servodevelop/piper-mate/hardware/README.md

# PiPER-Mate hardware

[← PiPER-Mate](../README.md)　|　<sub>**English** / [简体中文](README.zh.md)</sub>

<p align="center">
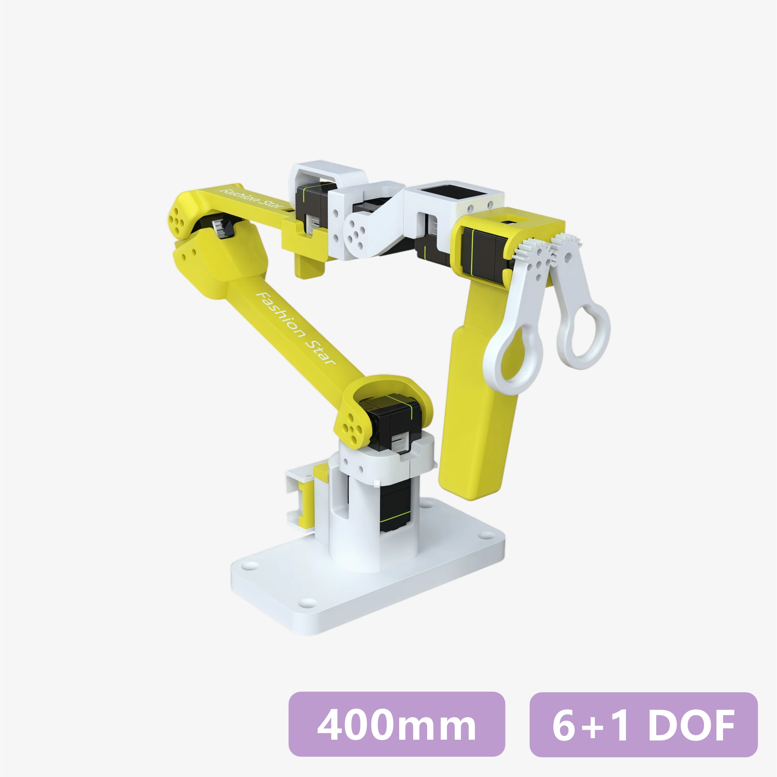
[picture p1: hardware/images/piper-mate-main-image-01.webp]
PiPER-Mate product view 1
  
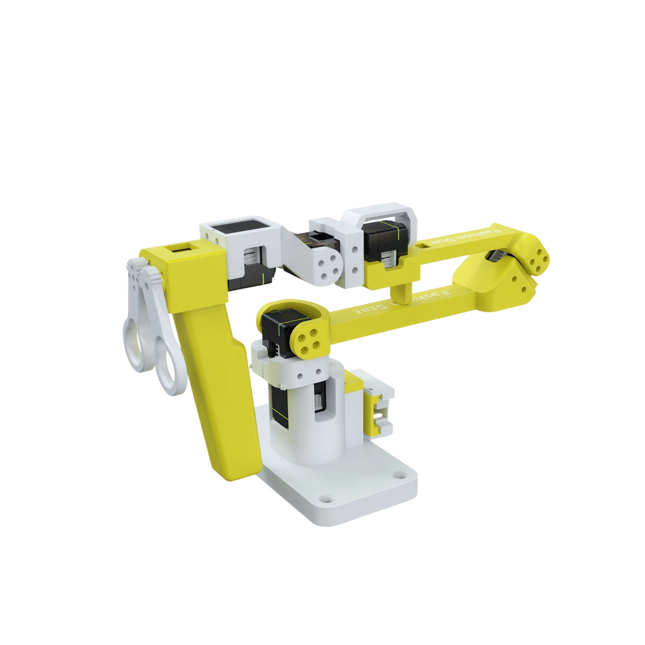
[picture p2: hardware/images/piper-mate-main-image-02.webp]
PiPER-Mate product view 2
  
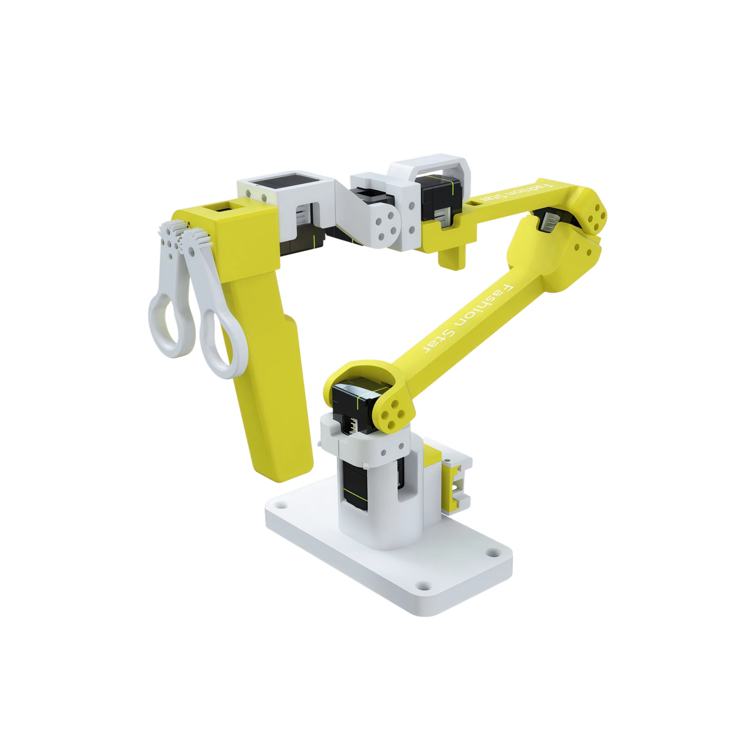
[picture p3: hardware/images/piper-mate-main-image-03.webp]
PiPER-Mate product view 3
  
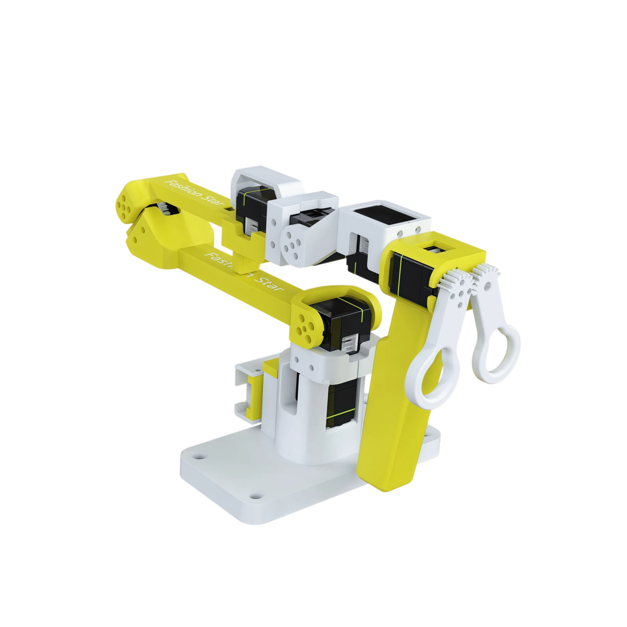
[picture p4: hardware/images/piper-mate-main-image-04.webp]
PiPER-Mate product view 4
  
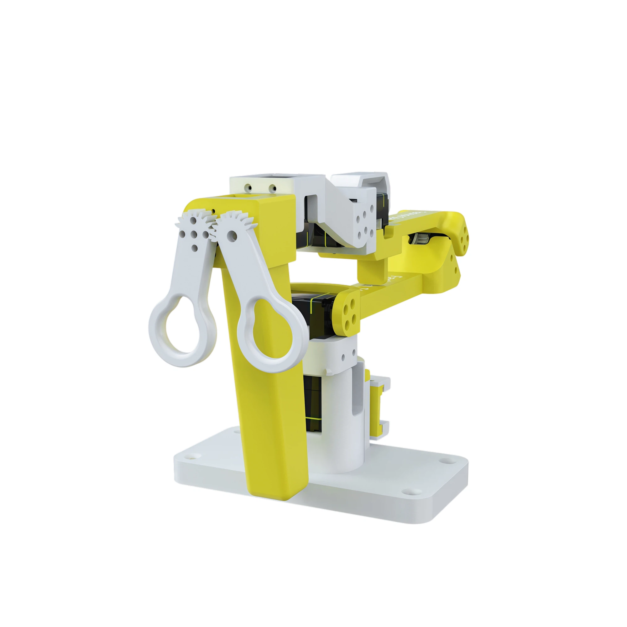
[picture p5: hardware/images/piper-mate-main-image-05.webp]
PiPER-Mate product view 5
  
</p>

**Contents:**

- [📂 Resources](#resources)
- [📋 Bill of Materials](#bill-of-materials)
- [🔢 Joint and servo ID mapping](../docs/specifications.md#joint-ids-and-names)

## Resources

| Directory | Description | Status |
| --- | --- | --- |
| [step/](step/) | [Complete assembly STEP](step/piper-mate.step) | ✅ Complete |
| [3mf/](3mf/) | 3D printing files (3MF) | — Coming soon |
| [drawings/](drawings/) | Dimension drawing in PDF and DWG | ✅ Complete |

The STEP assembly is a neutral CAD reference based on the supplied 2026-10-27 release folder.

The assembly tree groups the printed parts under `3D Printed Parts (11)` and the seven servos under `Servos (7)`. Servo instances are labeled `J1-ID0-RP6-U15H-M` through `J7-ID6-RP6-U15H-M (Handle)`; printed-part labels are `piper-mate-base`, `piper-mate-link 1`–`5`, `piper-mate-handle`, and `piper-mate-finger-ring-right` / `left`. The UC-01 adapter board cover and base are also in this group.

## Bill of Materials

The table lists **21 installed items**, with servos listed first. The Model / Specification column uses standardized identifiers for printed parts.

3MF printing files will be provided in [3mf/](3mf/); they are not yet available. Print settings are not listed here; choose layer height, wall count and infill for your printer and filament.

Screw images in rows 17–19 are AI-generated illustrations. The proportions in rows 17–18 have been adjusted for M1.6 × 4 mm; they are not dimensioned manufacturing drawings. Use the specification column for purchasing.

Cable images in rows 13–16 are AI-generated illustrations based on the connector reference. They are not to scale and do not define pin assignments; use the specification column for cable lengths and verify wiring against the actual hardware.

| No. | Part Name | Model / Specification | Image | Description | Quantity |
| :---: | --- | --- | :---: | --- | :---: |
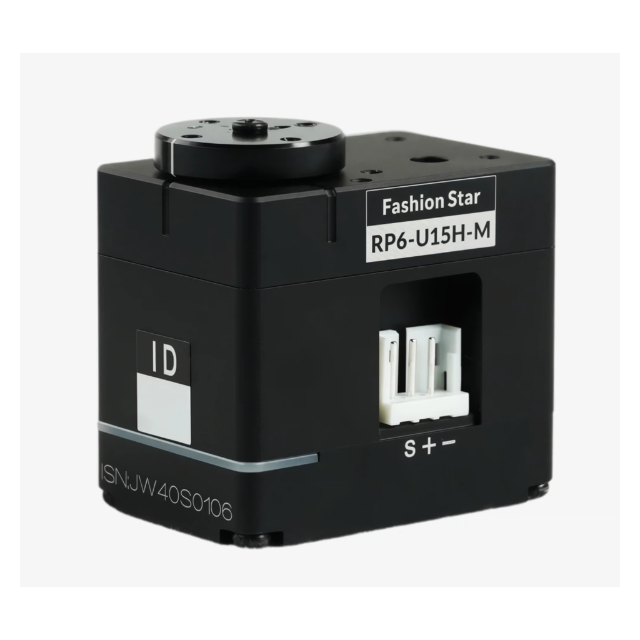
[picture p6: hardware/images/rp6-u15h-m.png]
RP6-U15H-M
| 1 | UART bus servo | RP6-U15H-M |  | Coreless motor; 12-bit absolute encoder; six arm joints plus trigger; J1-ID0–J7-ID6 | 7 |
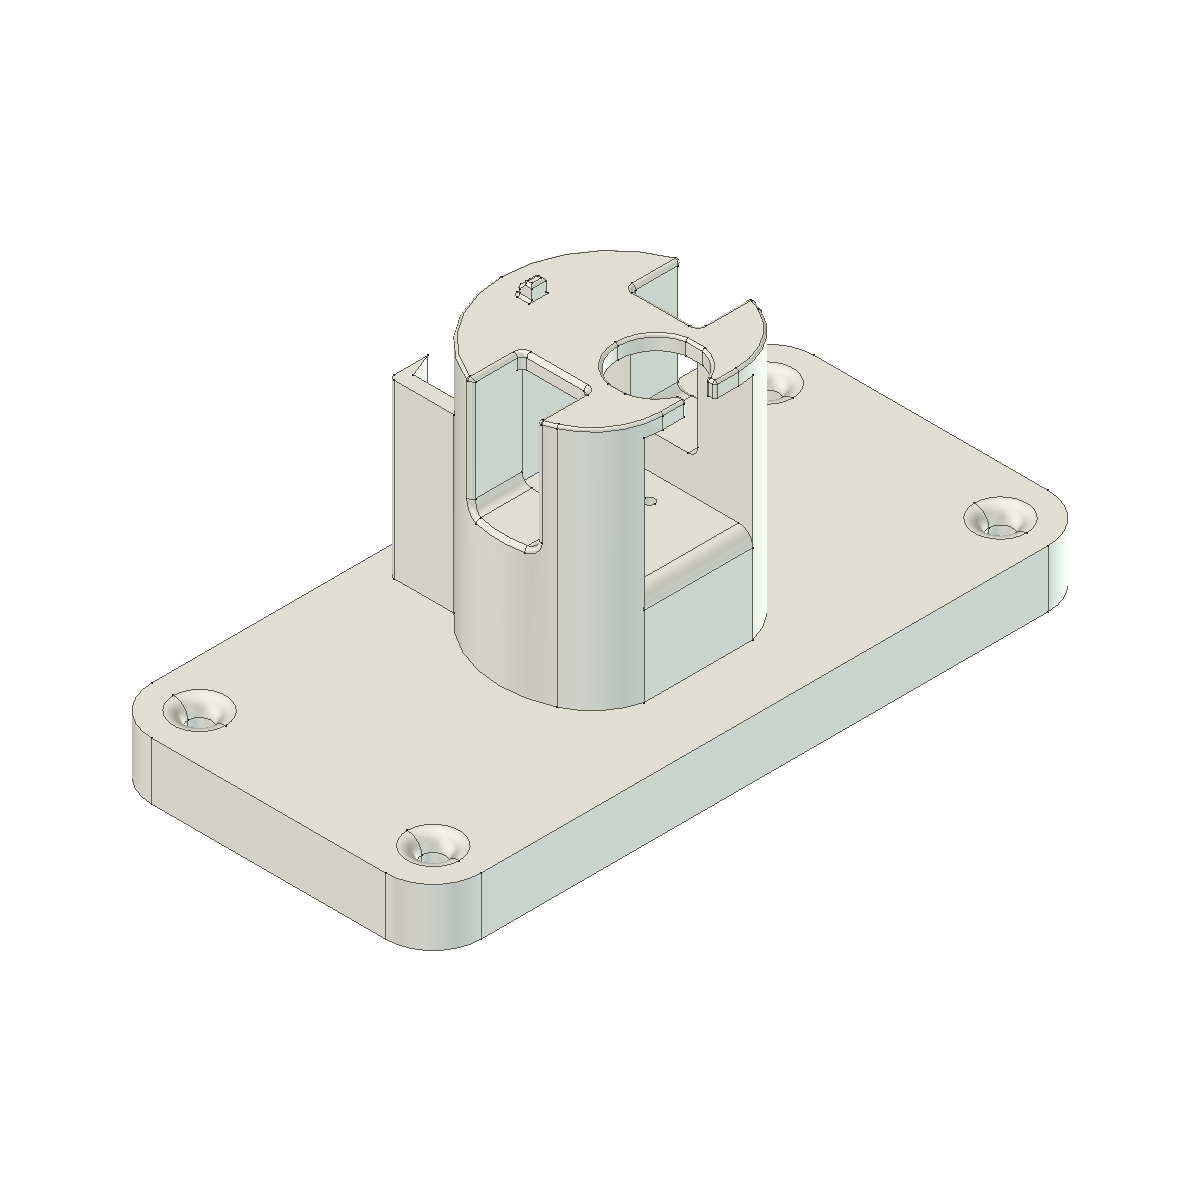
[picture p7: hardware/images/base.png]
base
| 2 | Base | piper-mate-base |  | Ivory, PLA 3D printed part | 1 |
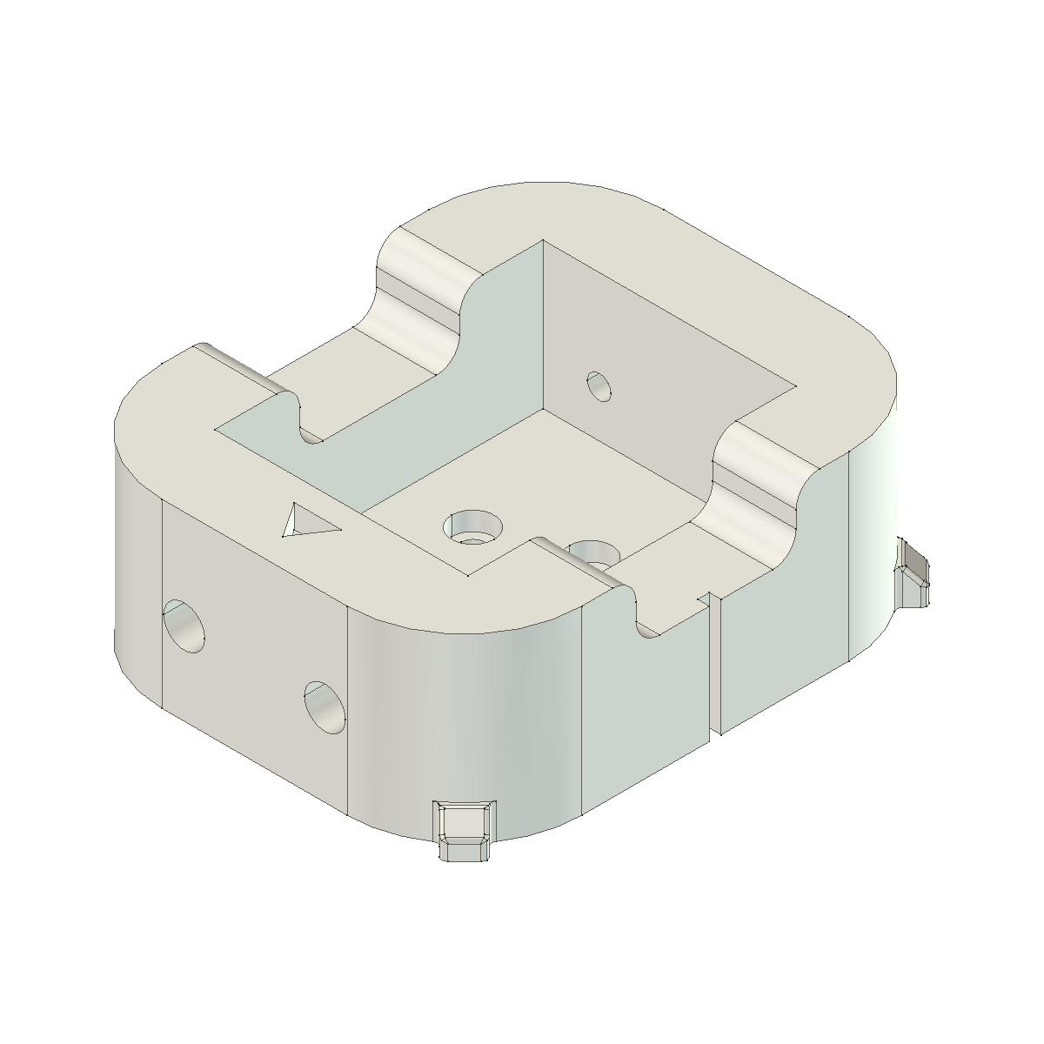
[picture p8: hardware/images/link1.png]
link1
| 3 | Link 1 | piper-mate-link1 |  | Ivory, PLA 3D printed part | 1 |
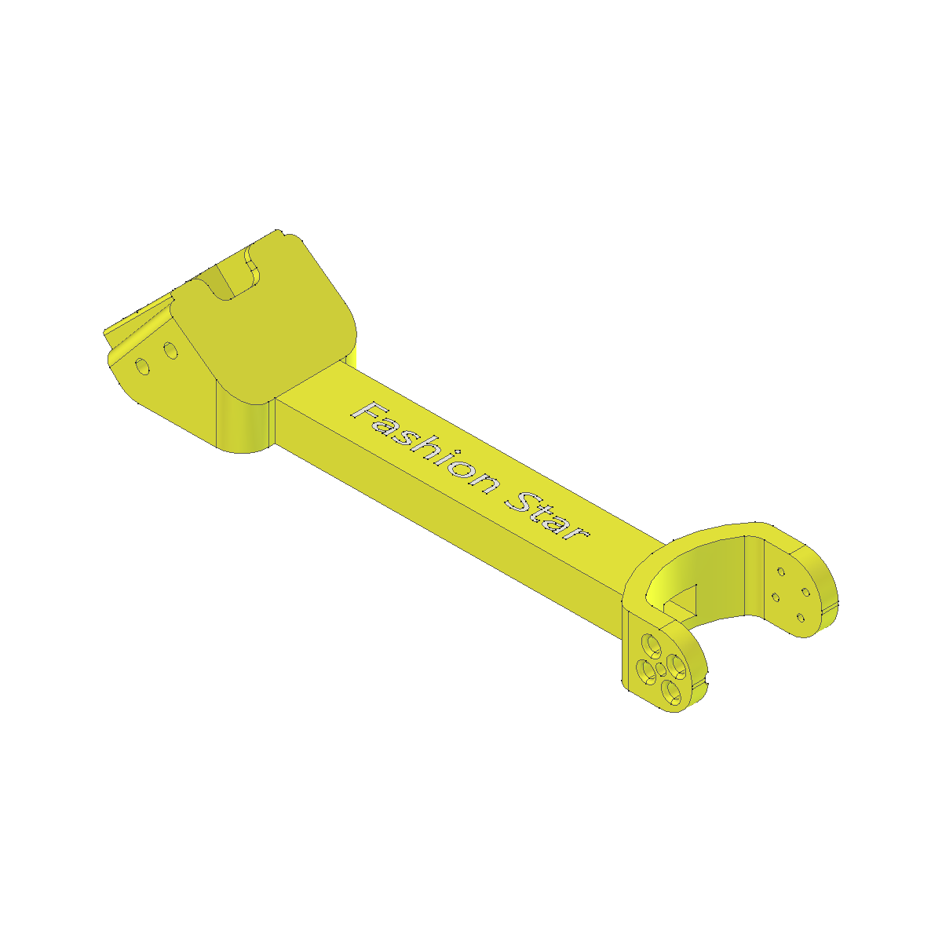
[picture p9: hardware/images/link2.png]
link2
| 4 | Link 2 | piper-mate-link2 |  | Yellow, PLA 3D printed part | 1 |
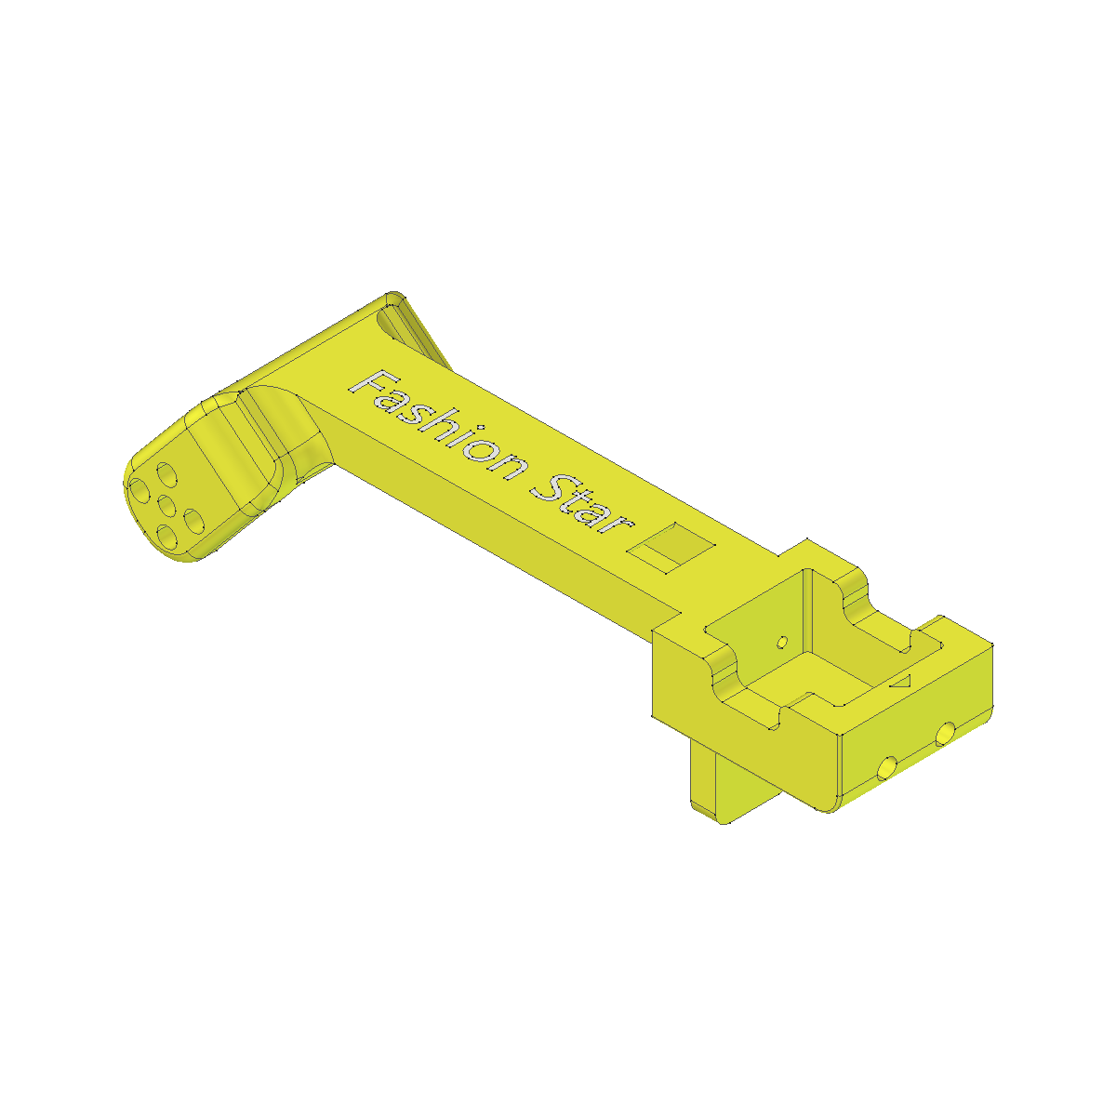
[picture p10: hardware/images/link3.png]
link3
| 5 | Link 3 | piper-mate-link3 |  | Yellow, PLA 3D printed part | 1 |
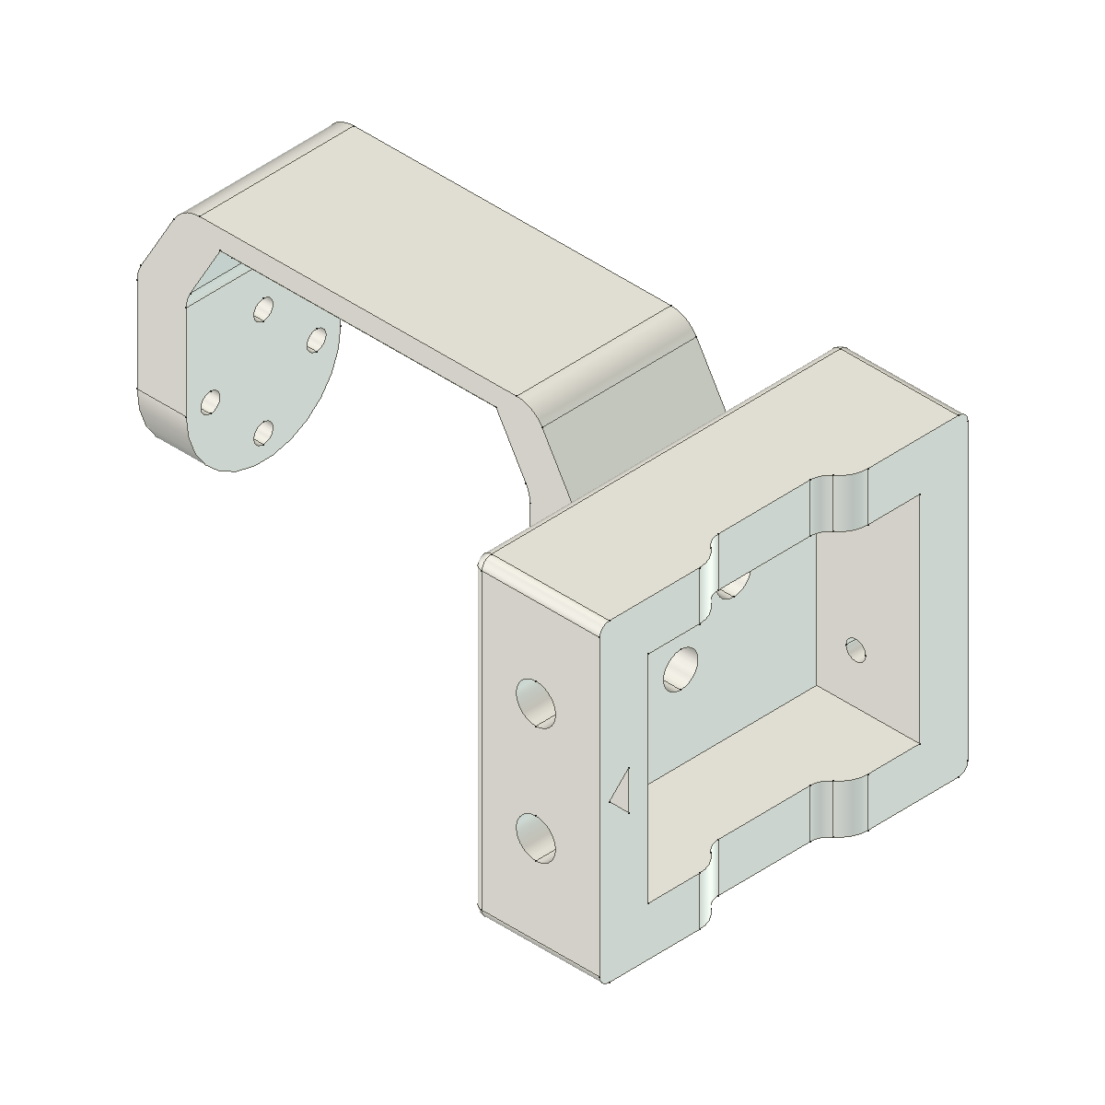
[picture p11: hardware/images/link4.png]
link4
| 6 | Link 4 | piper-mate-link4 |  | Ivory, PLA 3D printed part | 1 |
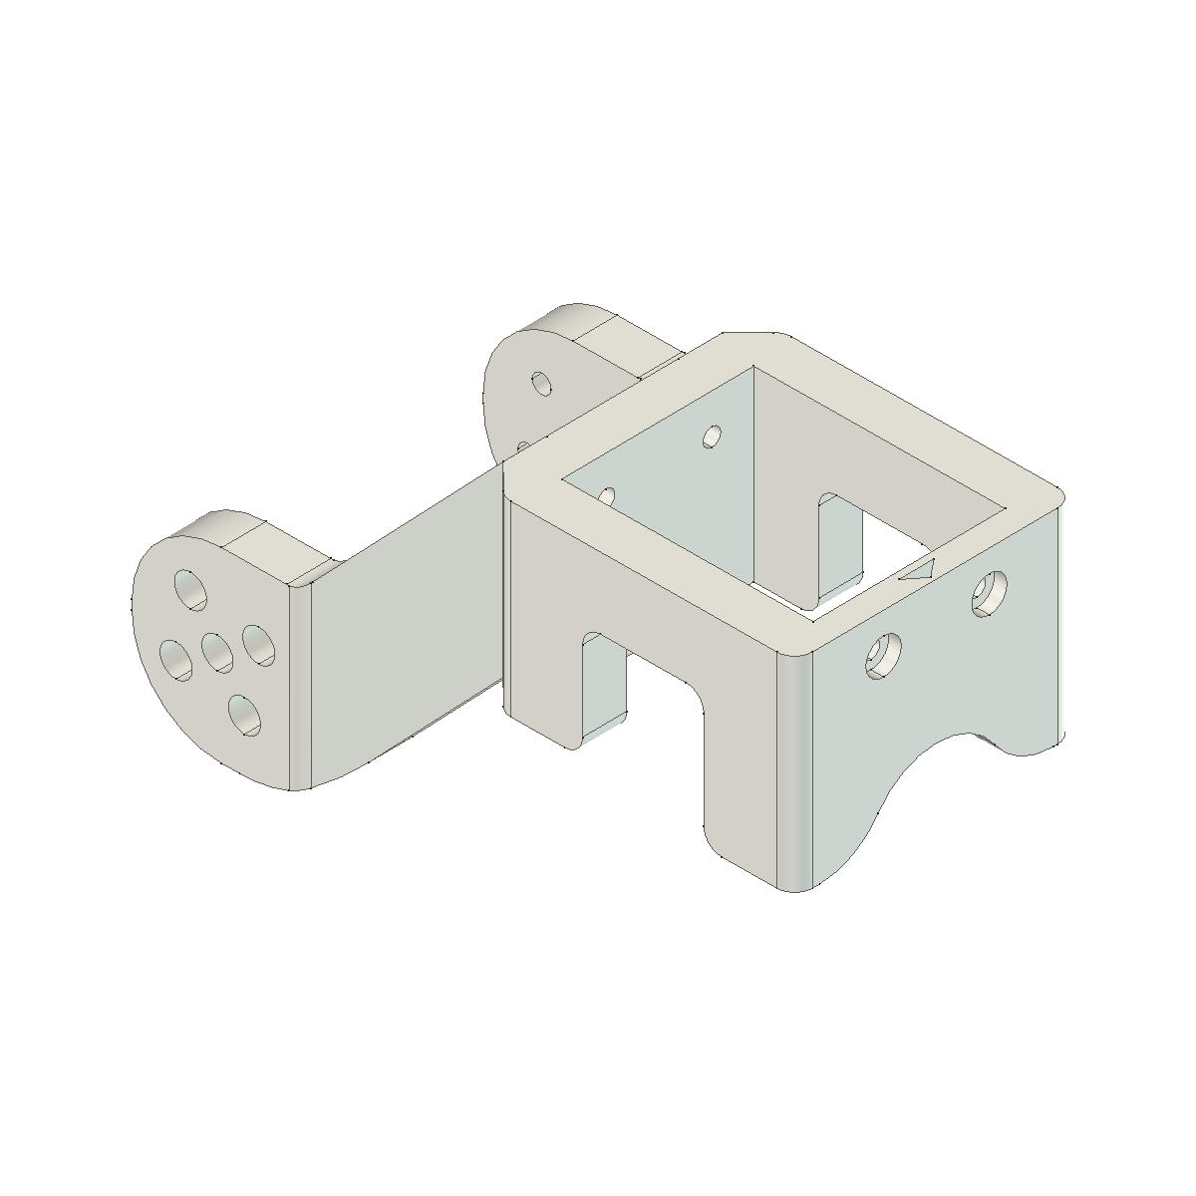
[picture p12: hardware/images/link5.png]
link5
| 7 | Link 5 | piper-mate-link5 |  | Ivory, PLA 3D printed part | 1 |
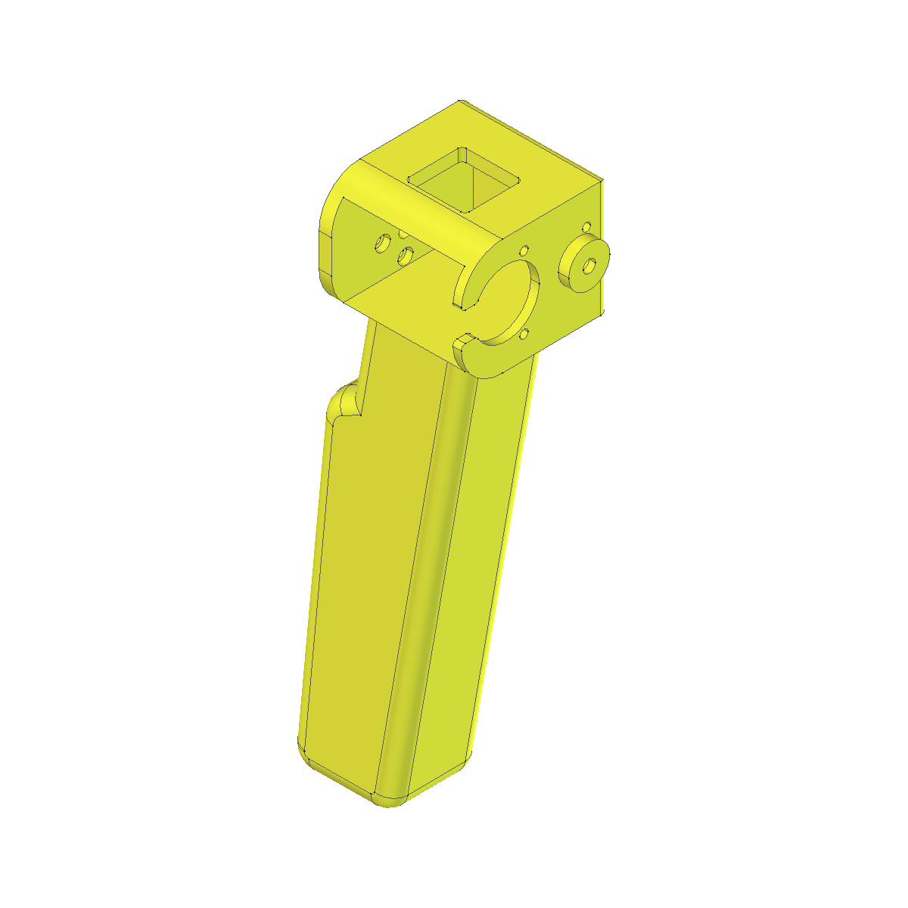
[picture p13: hardware/images/trigger.png]
handle
| 8 | Handle | piper-mate-handle |  | Yellow, PLA 3D printed part | 1 |
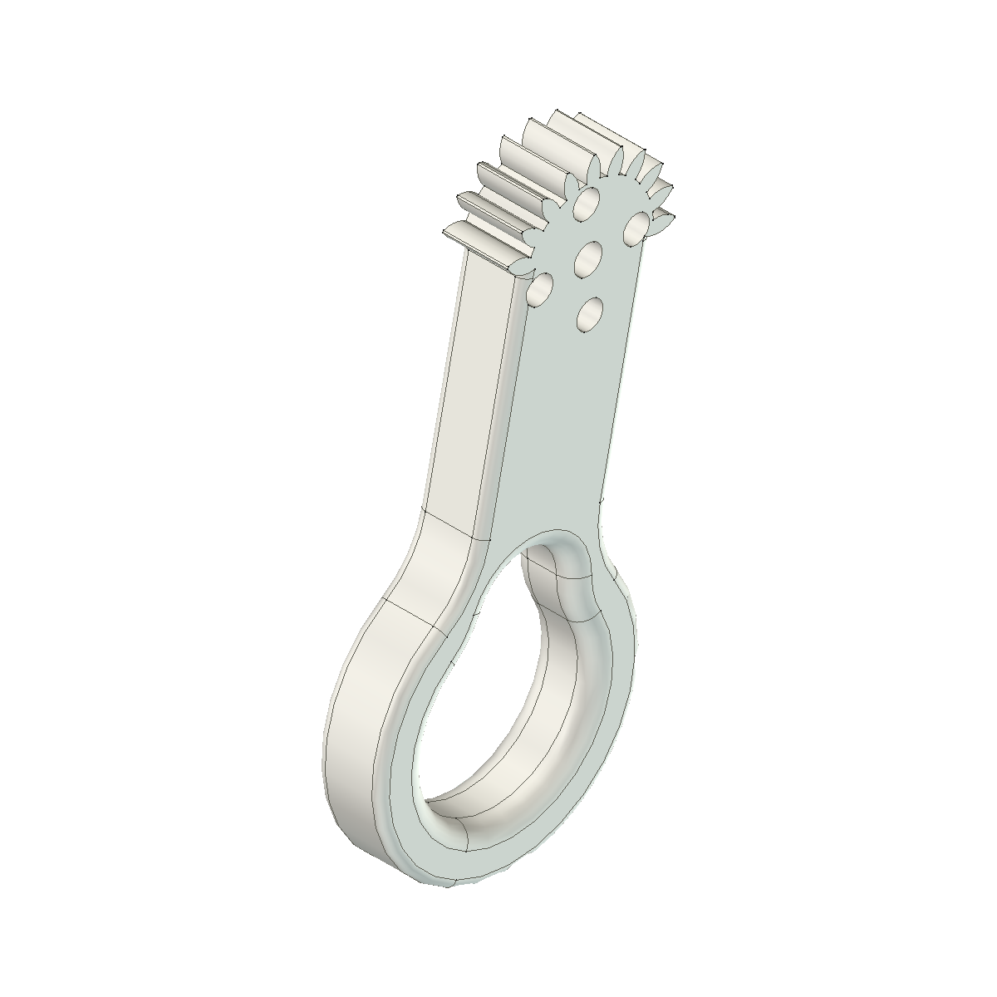
[picture p14: hardware/images/finger-ring-1.png]
right finger ring
| 9 | Right finger ring | piper-mate-finger-ring-right |  | Ivory, PLA 3D printed part | 1 |
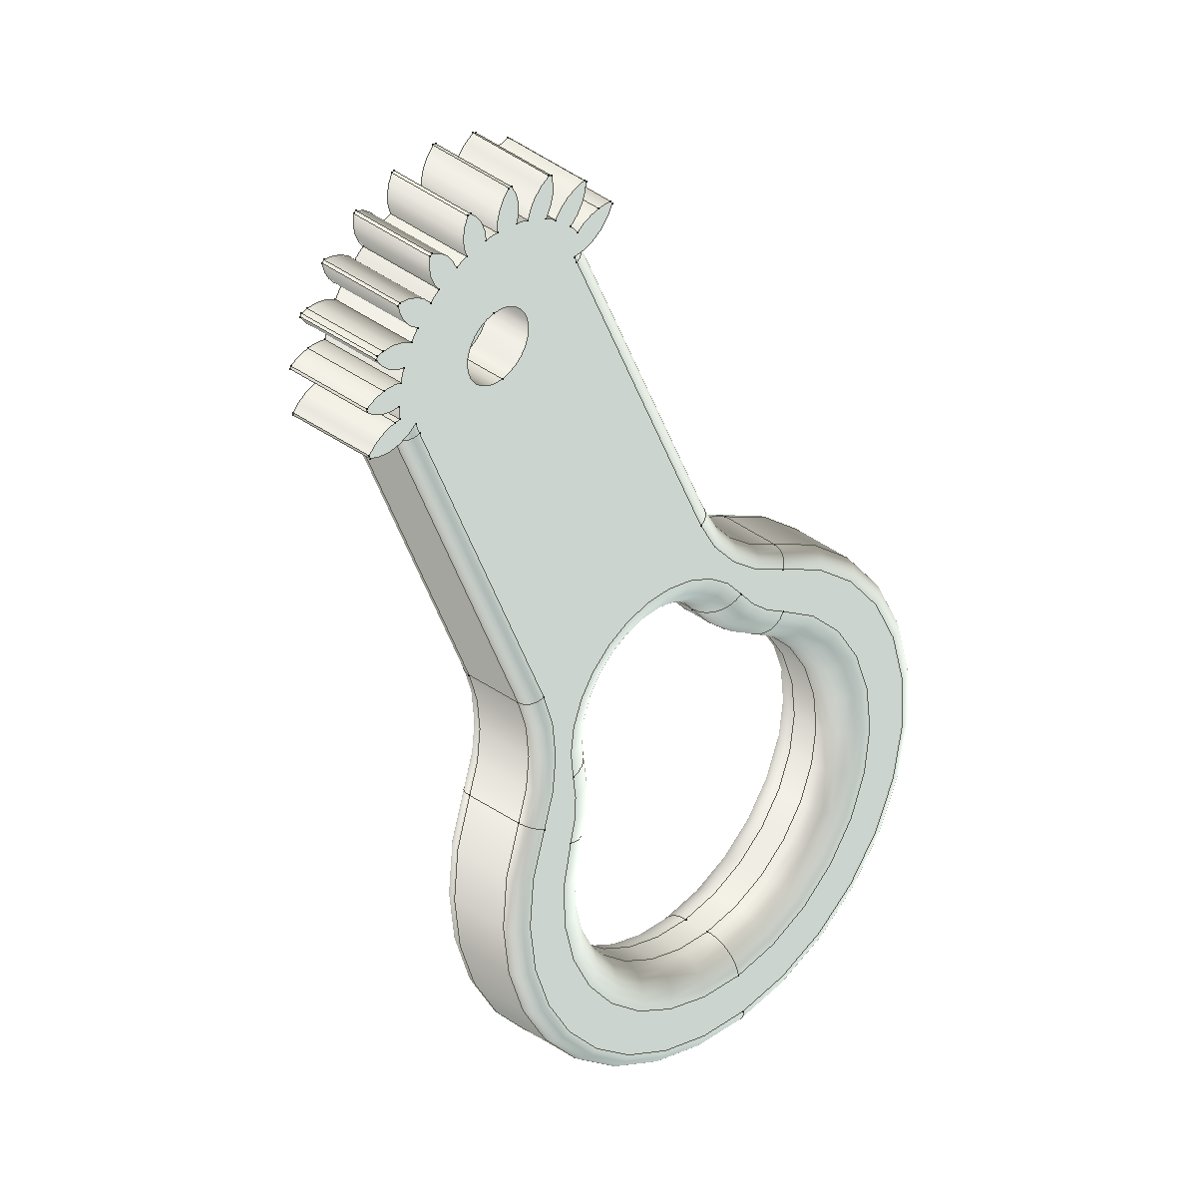
[picture p15: hardware/images/finger-ring-2.png]
left finger ring
| 10 | Left finger ring | piper-mate-finger-ring-left |  | Ivory, PLA 3D printed part | 1 |
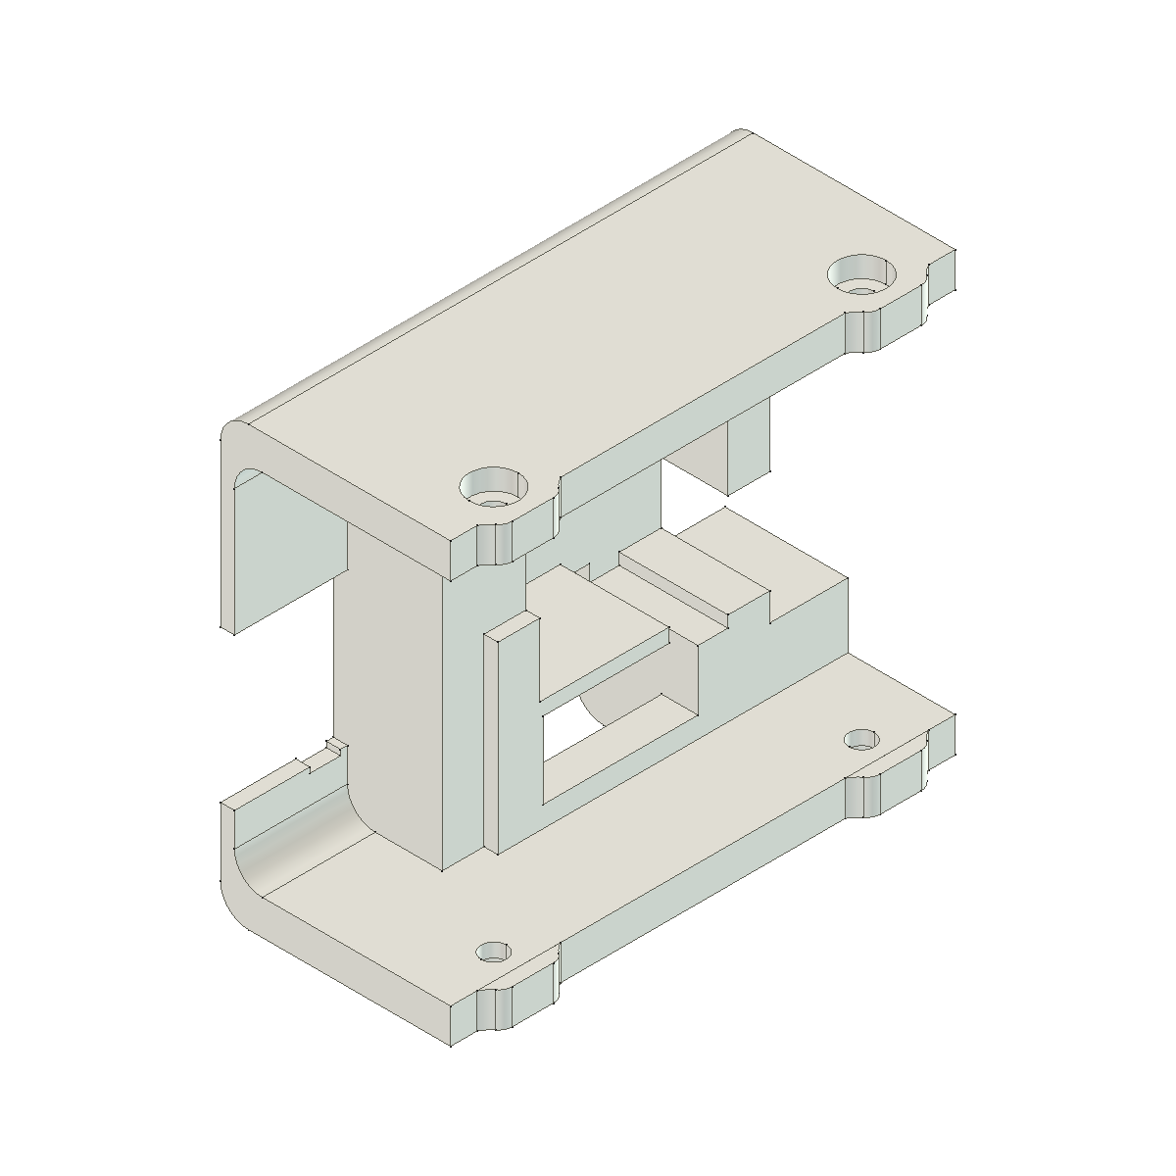
[picture p16: hardware/images/uc01-front-case.png]
UC-01 adapter board cover
| 11 | Adapter board cover | piper-mate-uc01-front-case |  | Ivory, PLA 3D printed part; UC-01 adapter board cover | 1 |
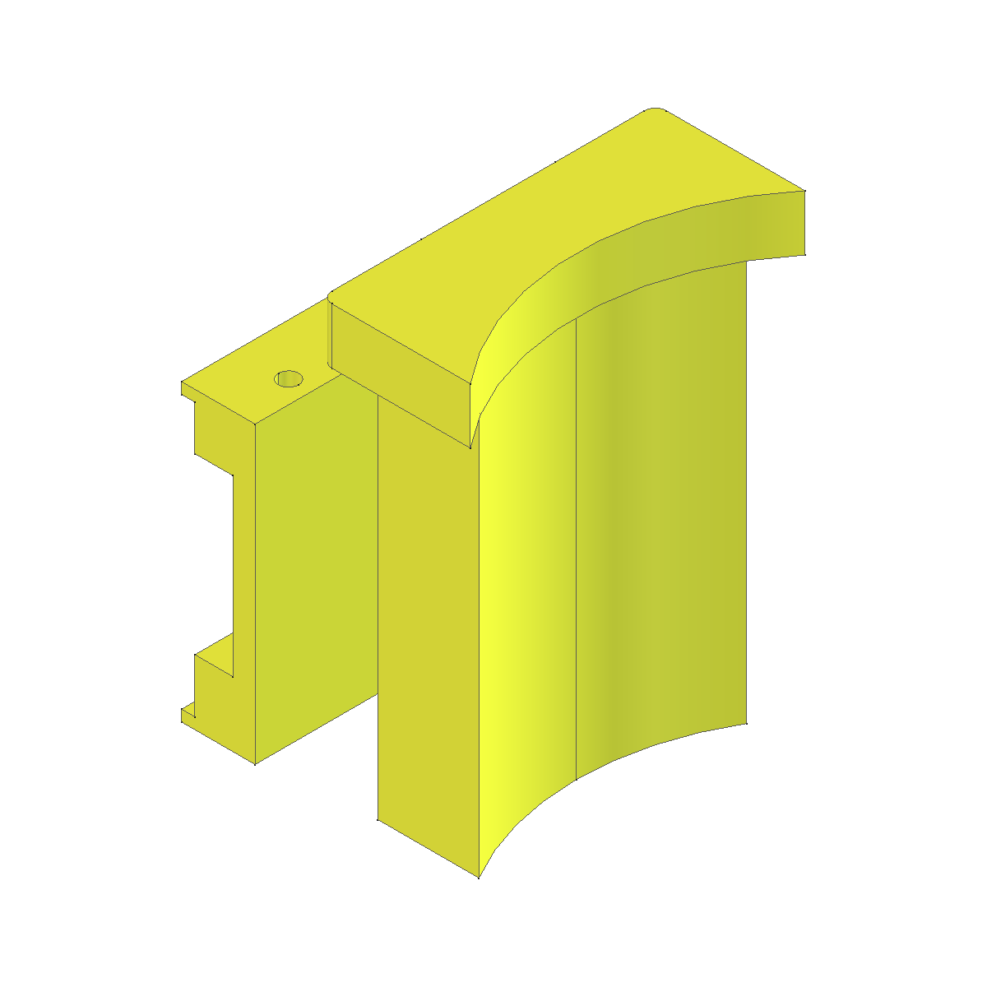
[picture p17: hardware/images/uc01-mount.png]
UC-01 adapter board base
| 12 | Adapter board base | piper-mate-uc01-mount |  | Yellow, PLA 3D printed part; UC-01 adapter board base | 1 |
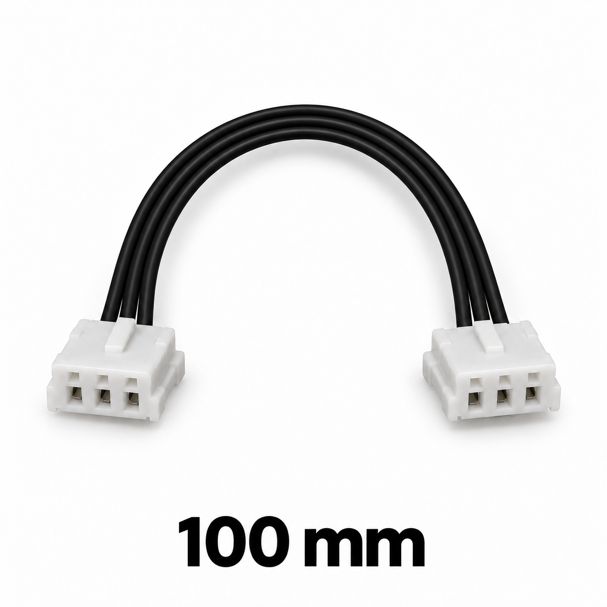
[picture p18: hardware/images/cables/a2007h03-servo-cable-100mm.png]
a2007h03 servo cable 100mm — AI-generated illustration
| 13 | Servo cable | A2007H03 × 2<br>100 mm |  | Reversed connector orientation between ends | 4 |
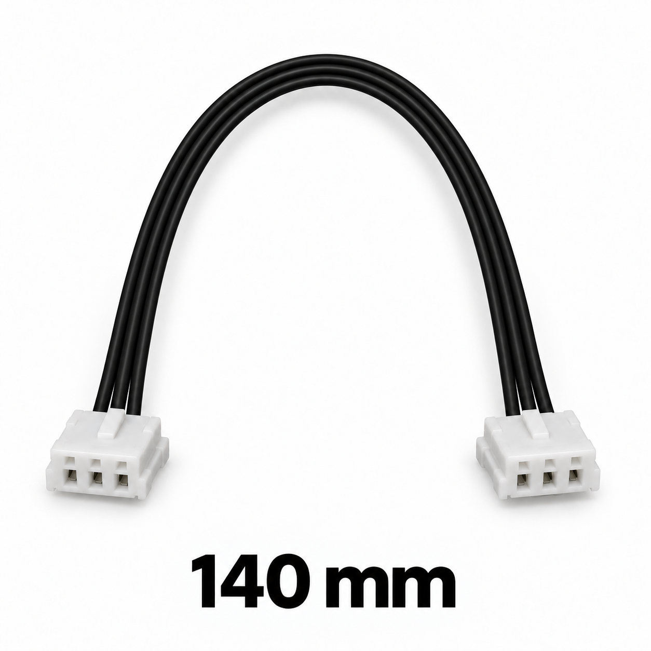
[picture p19: hardware/images/cables/a2007h03-servo-cable-140mm.png]
a2007h03 servo cable 140mm — AI-generated illustration
| 14 | Servo cable | A2007H03 × 2<br>140 mm |  | Reversed connector orientation between ends | 1 |
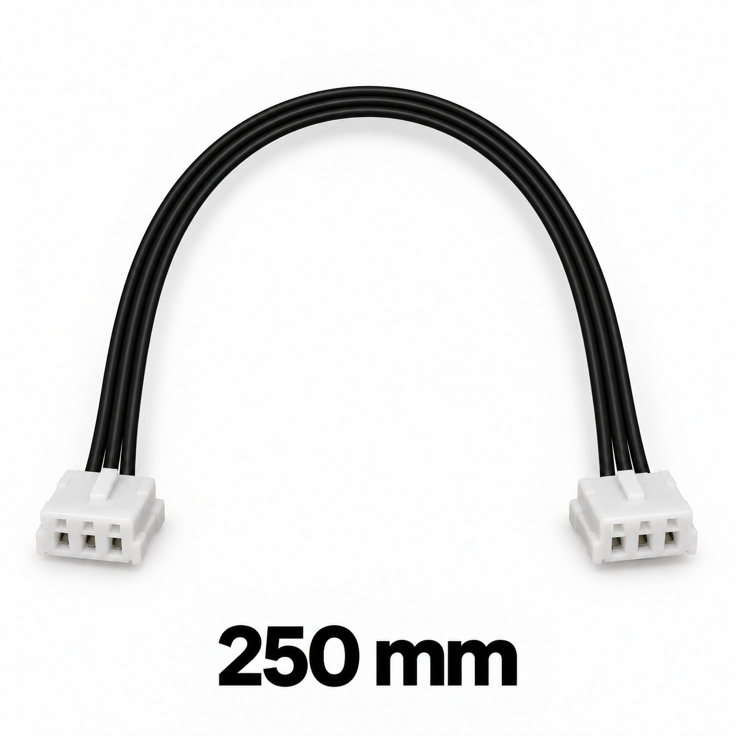
[picture p20: hardware/images/cables/a2007h03-servo-cable-250mm.png]
a2007h03 servo cable 250mm — AI-generated illustration
| 15 | Servo cable | A2007H03 × 2<br>250 mm |  | Reversed connector orientation between ends | 1 |
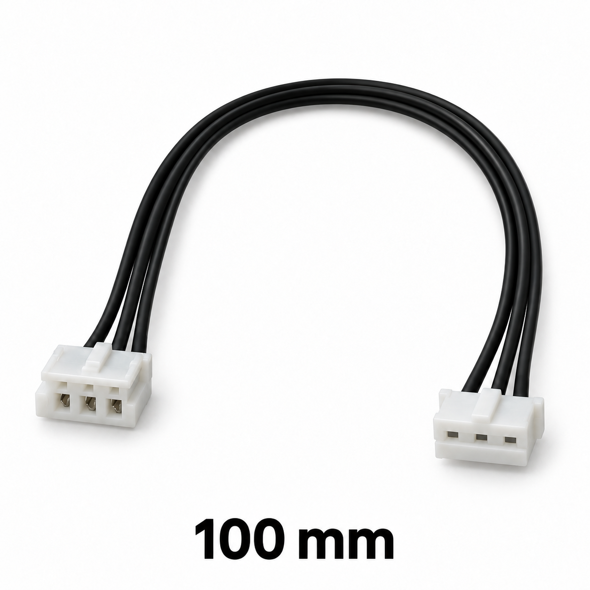
[picture p21: hardware/images/cables/a2007h03-ph2-0-adapter-cable-100mm.png]
a2007h03 ph2 0 adapter cable 100mm — AI-generated illustration
| 16 | Adapter cable | A2007H03 to PH2.0<br>100 mm |  | Same connector orientation at both ends | 1 |
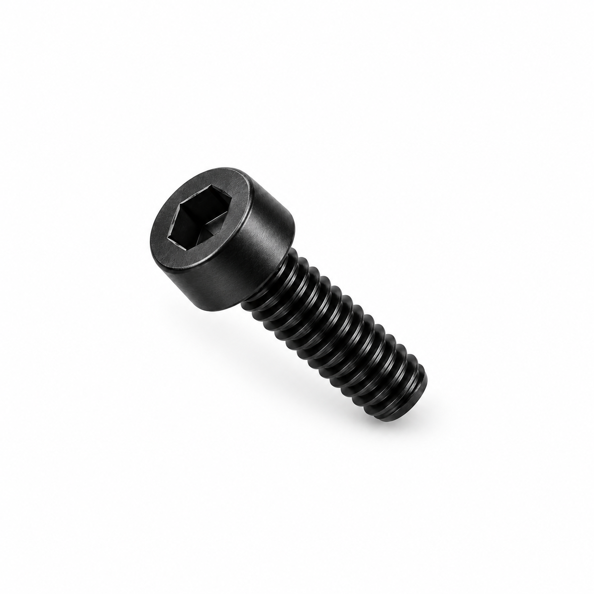
[picture p22: hardware/images/fasteners/m1-6-4-socket-head-cap-screw.png]
PM M1.6 × 4 mm hexagon socket head cap screw — AI-generated illustration
| 17 | Hexagon socket head cap screw | PM M1.6 × 4 mm |  | Black finish, property class 12.9 | 8 |
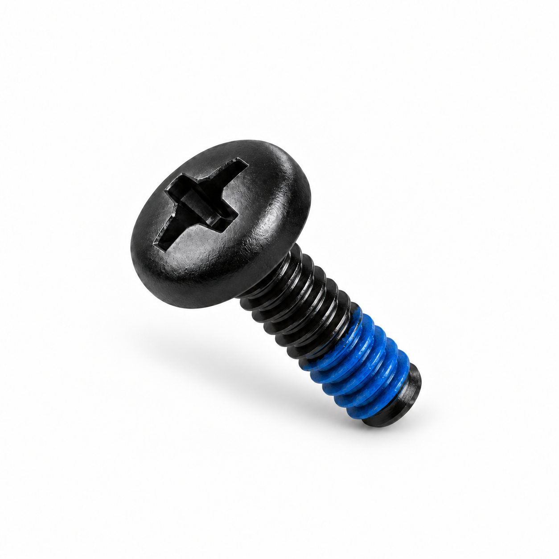
[picture p23: hardware/images/fasteners/m1-6-4-phillips-pan-head-screw.png]
PM M1.6 × 4 mm Phillips pan head machine screw — AI-generated illustration
| 18 | Phillips pan head machine screw | PM M1.6 × 4 mm |  | Black finish | 54 |
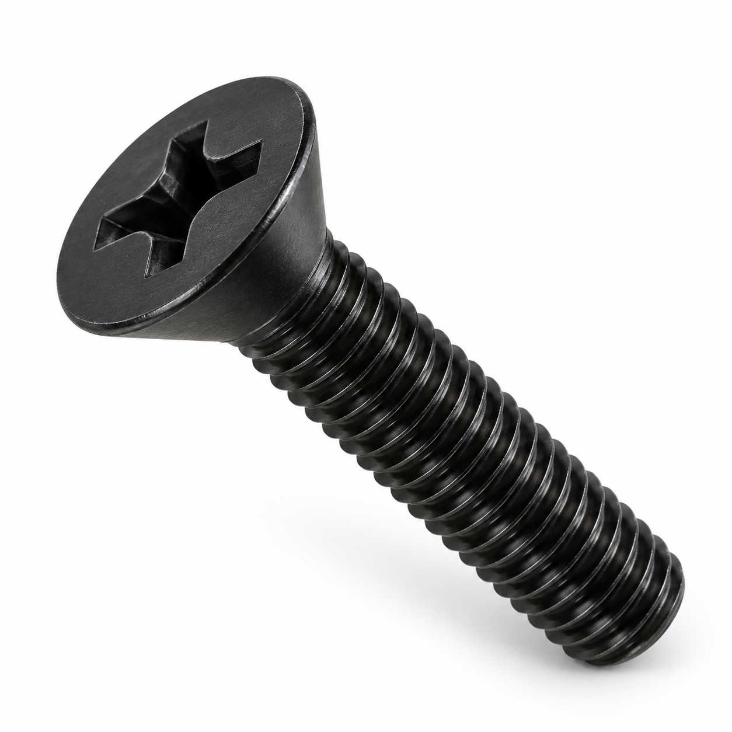
[picture p24: hardware/images/fasteners/m3-10-phillips-countersunk-head-screw.png]
Black M3 × 10 Phillips countersunk head screw — AI-generated illustration
| 19 | Phillips countersunk head machine screw | PM M3 × 10 mm |  | Black finish; AI-generated illustration | 1 |
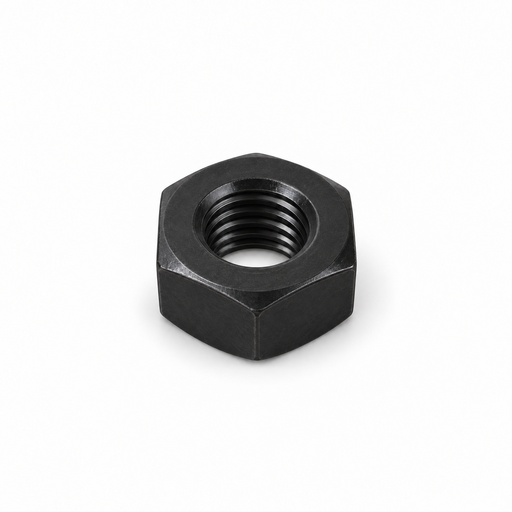
[picture p25: hardware/images/fasteners/m3-nut.png]
M3 locknut
| 20 | Locknut | M3 |  | Black finish | 1 |
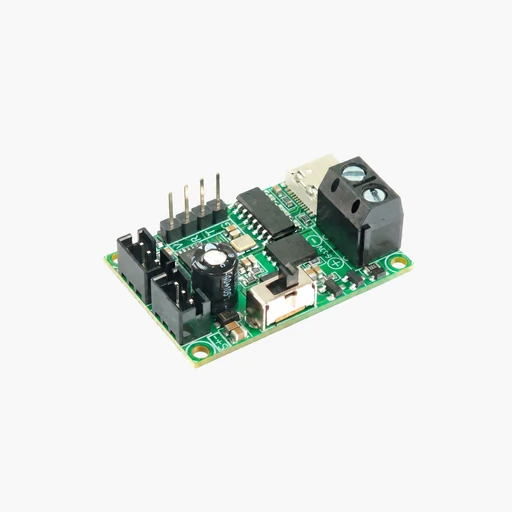
[picture p26: hardware/images/uc-01.webp]
UC-01
| 21 | TTL/USB servo adapter | UC-01 |  | PCBA with DC5521 female power lead; 0.75 mm² lead, 150 mm long | 1 |

## Licensing

Hardware licensing remains unresolved. No new license is granted by copying or renaming files.

Found an error in these resources or need help? Contact our [Support Hub](https://fashionstar.com.hk/support/) with your model and the relevant file or item.
