servodevelop/piper-mate/Lerobot/README.md

# lerobot_pipermate

## Getting Started

1. 下载lerobot仓库代码[github克隆lerobot](https://github.com/servodevelop/lerobot)

2. 根据[piper-star](./piper-star.md)文档进行操作
