servodevelop/piper-mate/hardware/images/dimensions.png

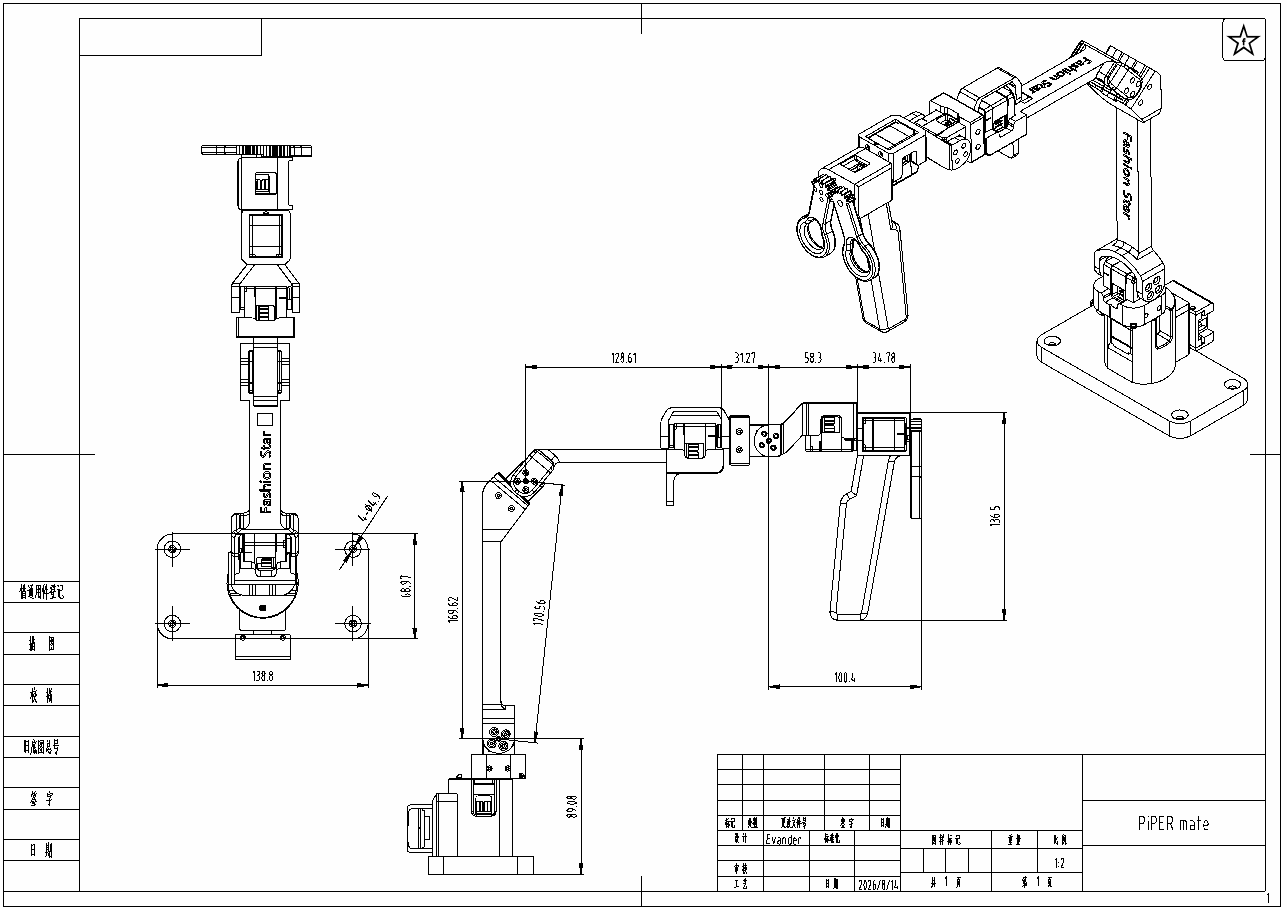
hardware/images/dimensions.png
