servodevelop/piper-mate/hardware/images/fasteners/m2-4-5-phillips-pan-head-screw.png

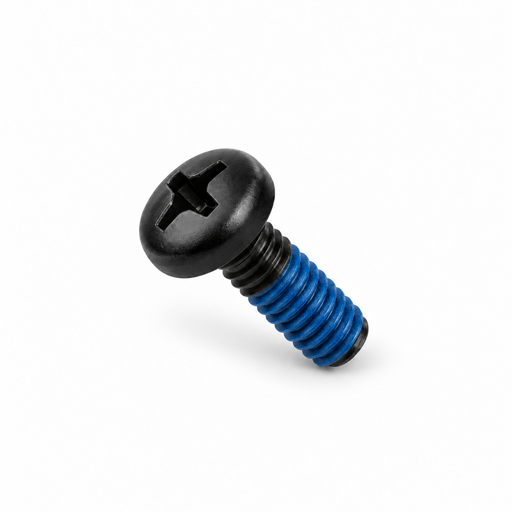
hardware/images/fasteners/m2-4-5-phillips-pan-head-screw.png
