servodevelop/piper-mate/hardware/images/uc01-cover.png

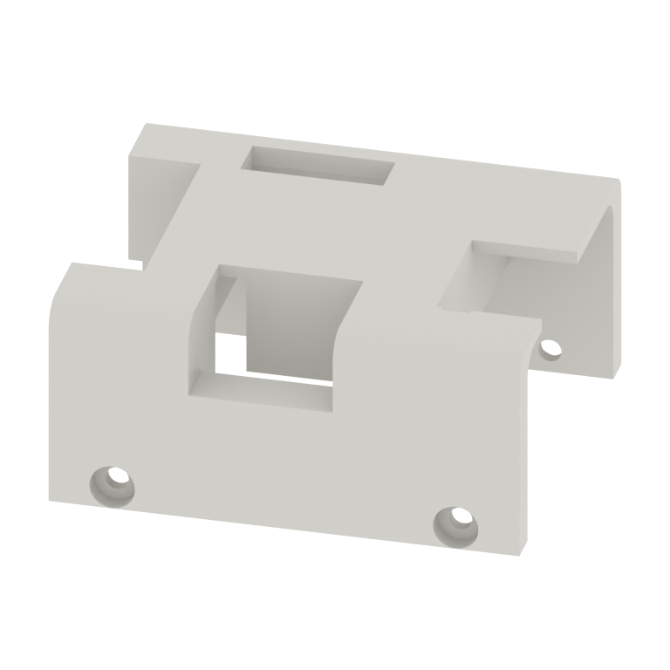
hardware/images/uc01-cover.png
