servodevelop/piper-mate/3D_Printable_Parts/Readme

All open-source 3D print files for the PiPER Mate robotic arm are stored here. Feel free to print and build your own!
