servodevelop/piper-mate/hardware/bom/piper-mate-bom-2026-07-21.xlsx

备料表
 | BOM代码 | 代码 | 物料名称 | 规格型号
 |  |  | piper mate
序号 | 代码 | 物料名称 | 规格型号 | 数量
1 |  | 3D打印件（piper底座) | Piper mate_ID0 PLA | 1
2 |  | 3D打印件（piper_link1) | Piper mate_ID1 PLA | 1
3 |  | 3D打印件（piper_link2) | Piper mate_ID2 PLA | 1
4 |  | 3D打印件（piper_link3) | Piper mate_ID3 PLA | 1
5 |  | 3D打印件（piper_link4) | Piper mate_ID4 PLA | 1
6 |  | 3D打印件（piper_link5) | Piper mate_ID5 PLA | 1
7 |  | 3D打印件（piper_trigger) | Piper mate_ID6-0 PLA | 1
7 |  | 3D打印件（piper_fingertip1) | Piper mate_ID6-1 PLA | 1
8 |  | 3D打印件（piper_fingertip2) | Piper mate_ID6-2 PLA | 1
9 |  | 连接线 | A2007H03*2 100mm 双头反向 | 4
10 |  | 连接线 | A2007H03*2 140mm 双头反向 | 1
11 |  | 连接线 | A2007H03*2 250mm 双头反向 | 1
12 |  | 连接线 | A2007H03转PH2.0 100mm 双头同向 | 1
13 |  | 舵机 | RP6-U15H-M | 7
14 |  | 螺丝 | PM M1.6x4mm 黑色内六角 12.9级 | 8
15 |  | 螺丝 | PM M1.6x4mm 十字槽 | 54
16 |  | 螺丝 | M3*10 十字槽螺杆黑色沉头 | 1
17 |  | 螺母 | M3防松螺母 黑色 | 1
18 |  | pcba | UC-01，接DC圆头电源线，0.75平方5.5x2.1母头, 0.15米 | 1
配件
19 | 01.04.01000026 | 白盒 | 160*125*60mm 小白盒 | 1
20 |  | 密封袋 | 120mmx80mm，用来装螺丝胶，上面贴一张标签纸，写： Threadlocker 1pcs 螺丝胶 | 1
21 | 01.06.02000101 | 螺丝胶 | 紫色222低强度 | 1
22 | 01.01.17000115 | 备用电源线 | XT30电源，公头，10cm | 1
23 | 01.05.01000018 | 数据线 | USB转type c数据线 1m 黑色 1A | 1
24 | 01.06.04000011 | 木工夹 | 4寸F夹 | 2
25 | 03.01.00000107 | PCBA | UC-01 （不配任何电源线） | 1
26 |  | 连接线 | A2007H03*2 250mm 双头反向 | 1
27 |  | 螺丝 | M1.6x4，12.9硬度，用小密封袋装，上面贴一张标签纸，写：Phillips Screw M1.6*4, 5pcs | 5
28 |  | 螺丝 | M1.6x4，用小密封袋装，上面贴一张标签纸，写：Phillips Screw M1.6*4, 8pcs | 8
制表人： |  | 确认： | 审核：
