servodevelop/piper-mate/3D_Printable_Parts/底座.STEP

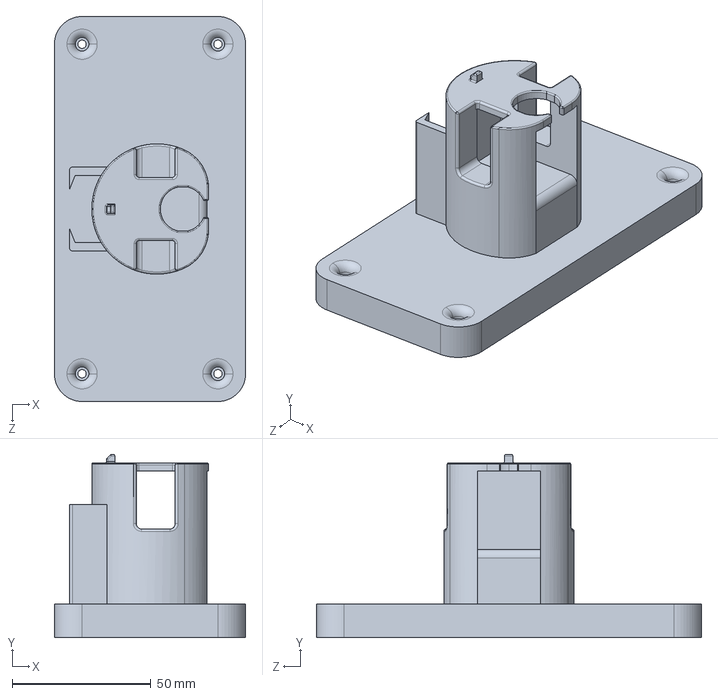
[picture p30: CAD file, 2026-07-08]
3D_Printable_Parts/底座.STEP
69.0 x 66.0 x 138.8 mm
