servodevelop/piper-mate/hardware/printing/3mf/piper-mate-09-01.3mf

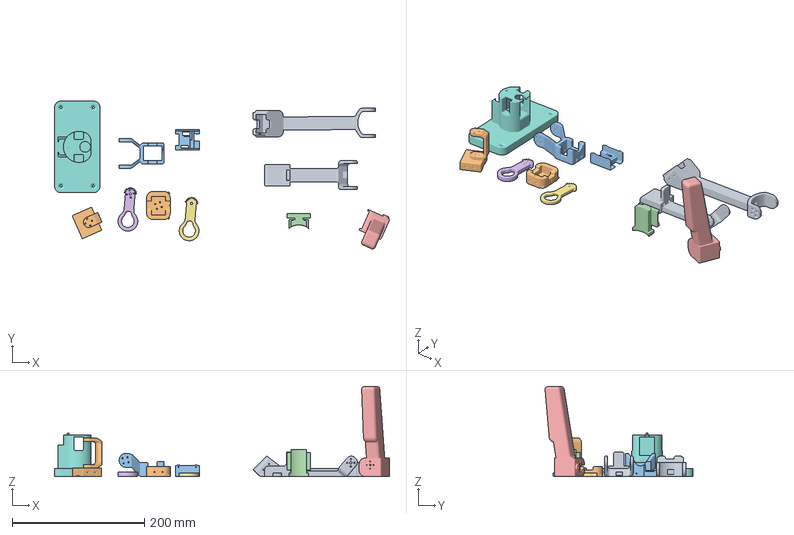
[picture p31: CAD file, 2026-10-27]
hardware/printing/3mf/piper-mate-09-01.3mf
507.1 x 223.9 x 136.3 mm
link2.STEP
Link4.STEP
link5.STEP
uc01板块.STEP
手柄.STEP
指环1.STEP
指环2.STEP
底座优化.STEP
link3优化222.STEP
link1优化222.STEP
UC01front_case.STEP
