servodevelop/piper-mate/hardware/step/assembly/piper-mate-c050.step

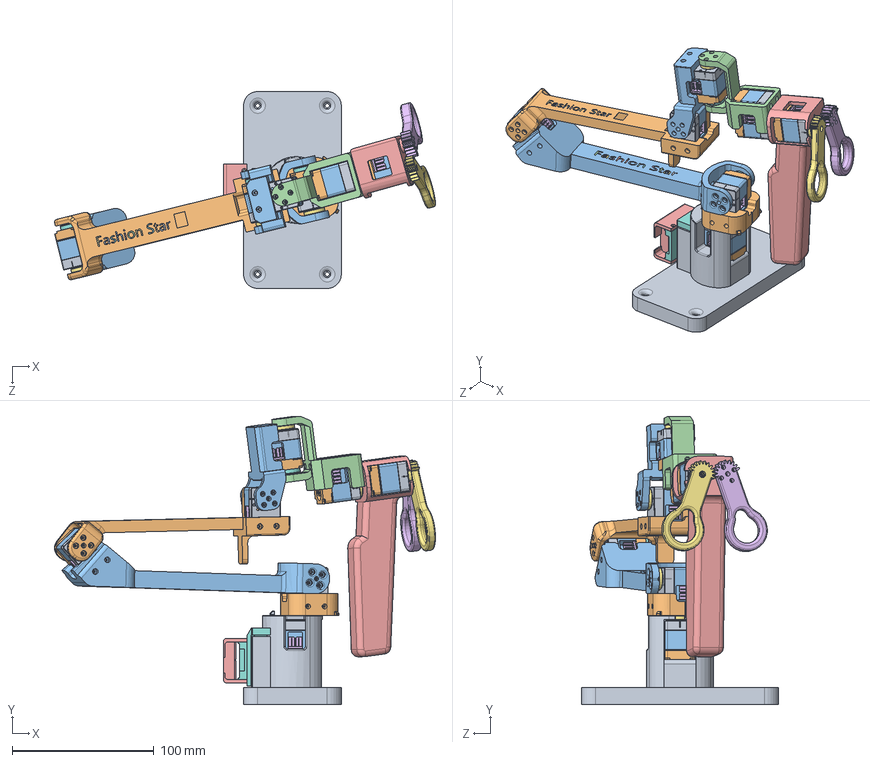
[picture p32: CAD file, 2026-10-30]
hardware/step/assembly/piper-mate-c050.step
268.4 x 203.2 x 138.8 mm
piper-mate-c050-base
piper-mate-c050-link1
piper-mate-c050-link2
piper-mate-c050-link3
piper-mate-c050-link4
piper-mate-c050-link5
piper-mate-c050-handle
piper-mate-c050-finger-ring-right
piper-mate-c050-finger-ring-left
piper-mate-c050-uc01-front-case
piper-mate-c050-uc01-mount
sg.stp x 7
led31 x 7
piper-mate-c050-main-horn x 7
piper-mate-c050-assistant-horn x 4
