servodevelop/piper-mate/hardware/step/parts/piper-mate-handle.step

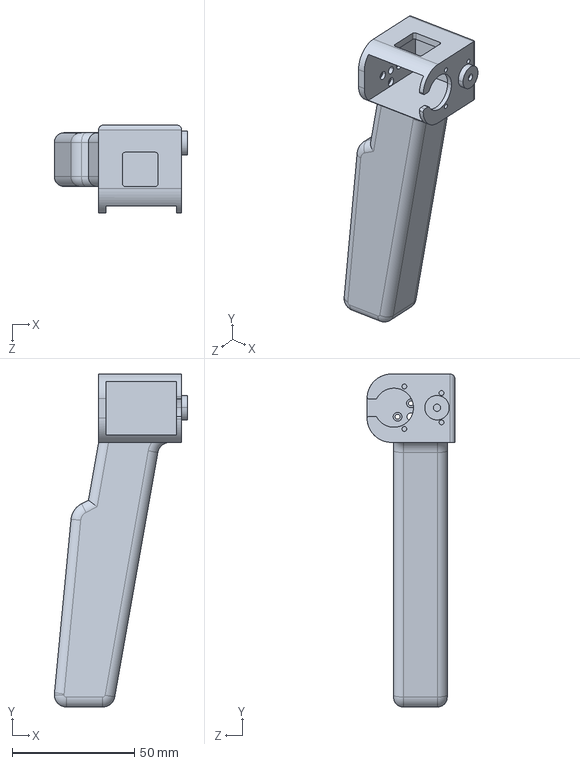
[picture p33: CAD file, 2026-10-30]
hardware/step/parts/piper-mate-handle.step
54.6 x 136.3 x 36.0 mm
