servodevelop/piper-mate/hardware/step/piper-mate.step

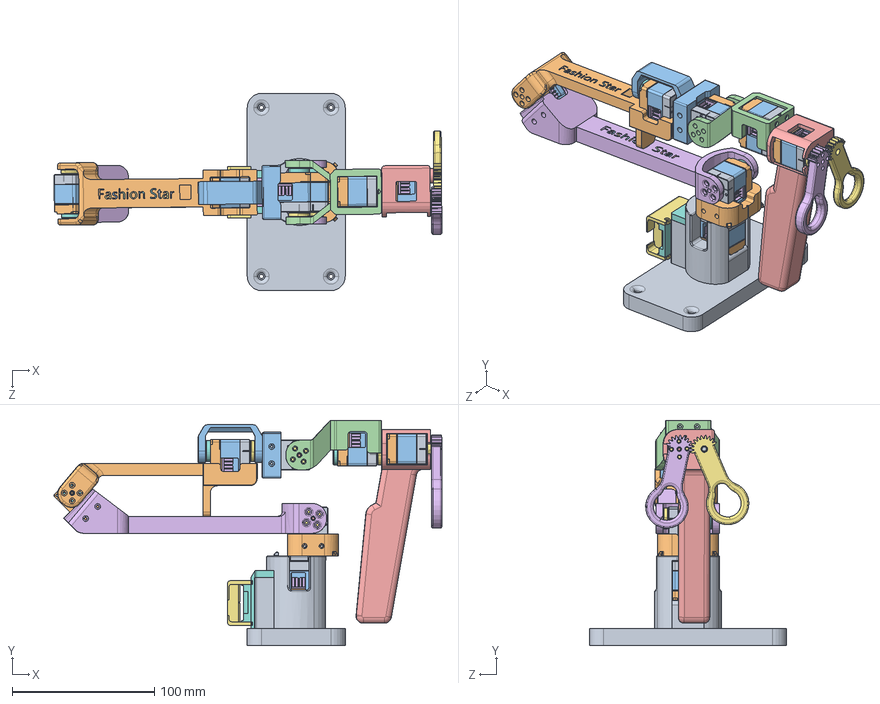
[picture p34: CAD file, 2026-11-01]
hardware/step/piper-mate.step
273.0 x 158.6 x 138.8 mm
piper-mate-base
piper-mate-link 1
piper-mate-link 2
piper-mate-link 3
piper-mate-link 4
piper-mate-link 5
piper-mate-handle
piper-mate-finger-ring-right
piper-mate-finger-ring-left
piper-mate-uc01-front-case
piper-mate-uc01-mount
J1-ID0-RP6-U15H-M
J2-ID1-RP6-U15H-M
J3-ID2-RP6-U15H-M
J4-ID3-RP6-U15H-M
J5-ID4-RP6-U15H-M
J6-ID5-RP6-U15H-M
J7-ID6-RP6-U15H-M (Handle)
