servodevelop/piper-mate/hardware/stl/uc01-cover.stl

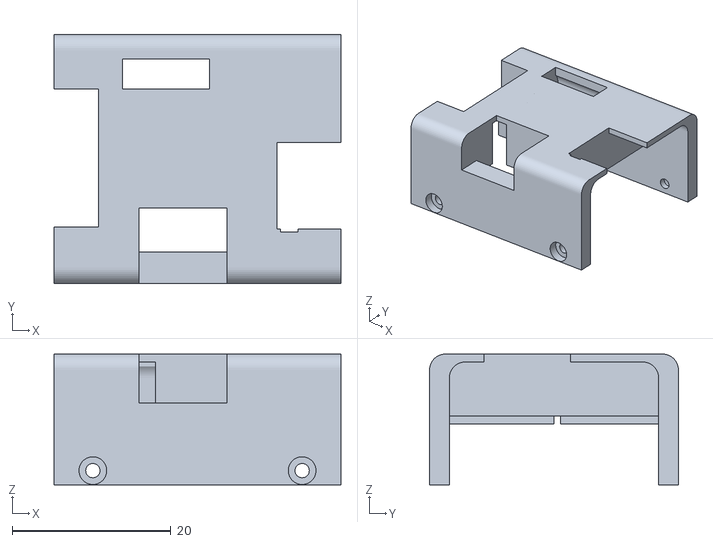
[picture p35: CAD file, 2026-10-27]
hardware/stl/uc01-cover.stl
36.2 x 31.4 x 16.5
