servodevelop/piper-mate/3D_Printable_Parts/指环1.STEP

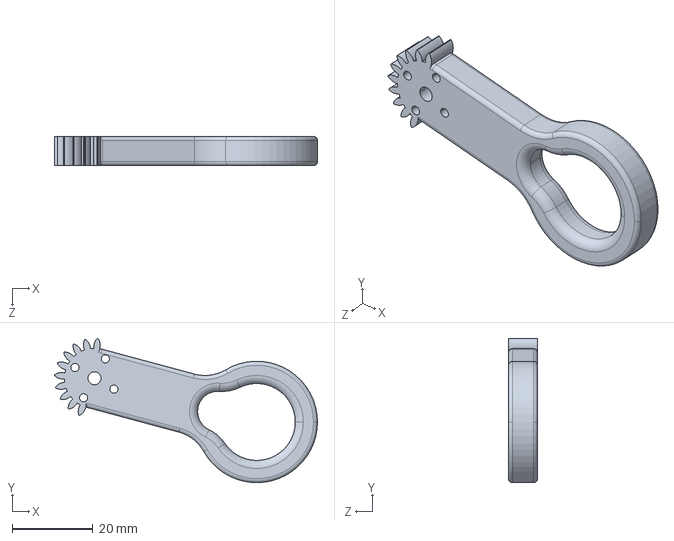
[picture p36: CAD file, 2026-07-08]
3D_Printable_Parts/指环1.STEP
65.0 x 35.7 x 7.22 mm
