servodevelop/piper-mate/hardware/stl/finger-ring-2.stl

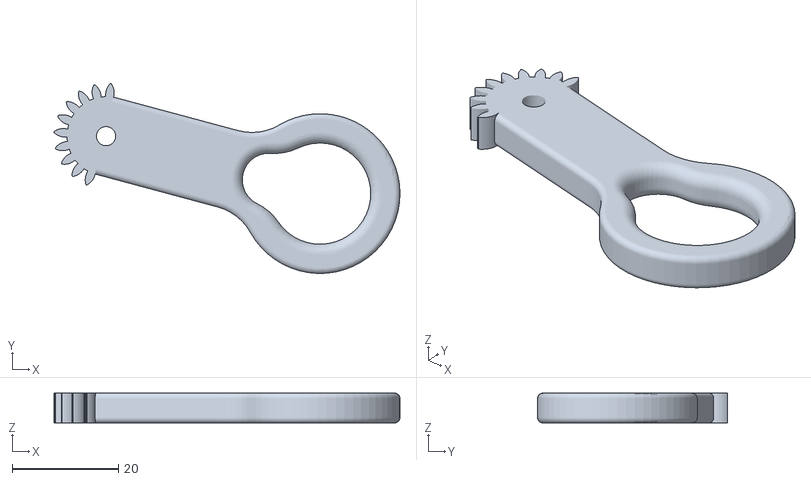
[picture p37: CAD file, 2026-10-27]
hardware/stl/finger-ring-2.stl
65.0 x 35.7 x 5.60
