servodevelop/piper-mate/3D_Printable_Parts/link1.STEP

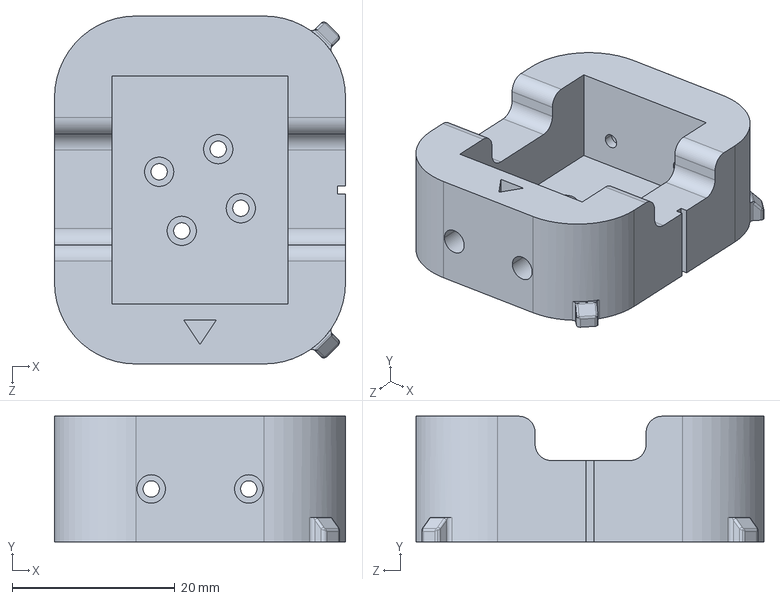
[picture p38: CAD file, 2026-07-08]
3D_Printable_Parts/link1.STEP
35.8 x 15.5 x 42.8 mm
