servodevelop/piper-mate/hardware/step/parts/piper-mate-uc01-front-case.step

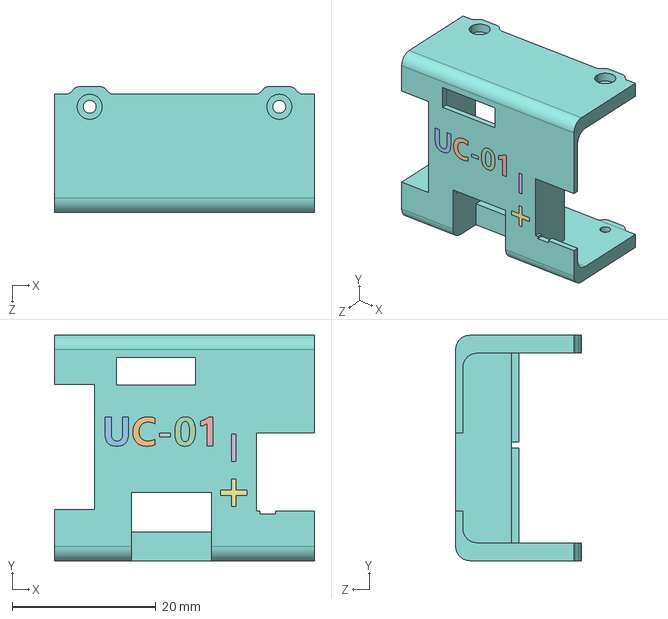
[picture p39: CAD file, 2026-10-30]
hardware/step/parts/piper-mate-uc01-front-case.step
36.2 x 31.4 x 17.5 mm
