servodevelop/piper-mate/3D_Printable_Parts/Link4.STEP

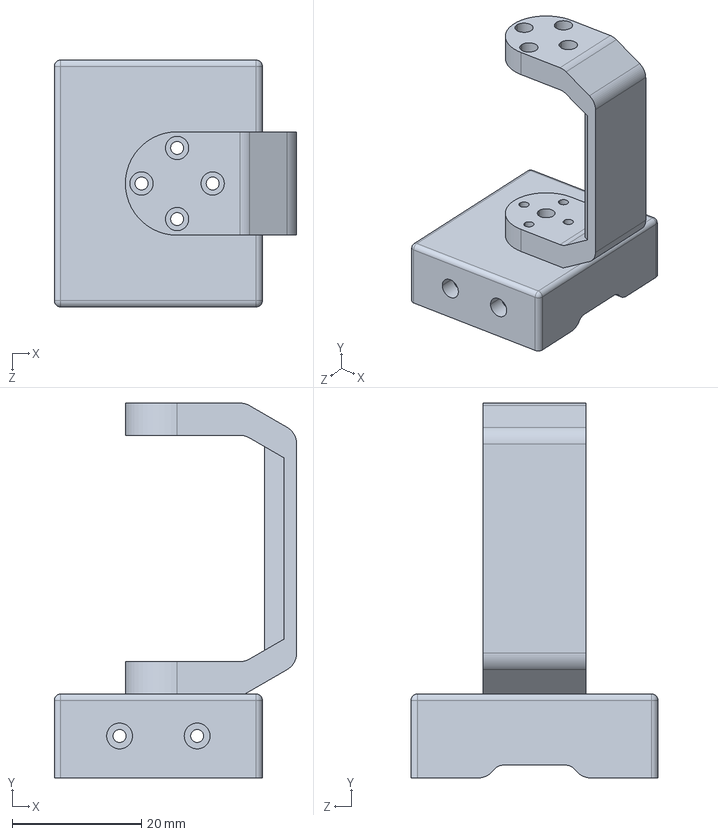
[picture p40: CAD file, 2026-07-08]
3D_Printable_Parts/Link4.STEP
37.5 x 58.0 x 38.2 mm
