servodevelop/piper-mate/hardware/step/parts/piper-mate-link5.step

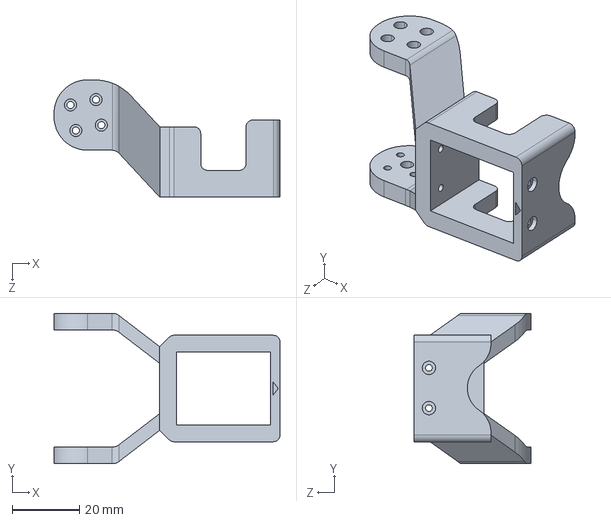
[picture p41: CAD file, 2026-10-30]
hardware/step/parts/piper-mate-link5.step
67.5 x 44.9 x 35.0 mm
