servodevelop/piper-mate/3D_Printable_Parts/uc01板块.STEP

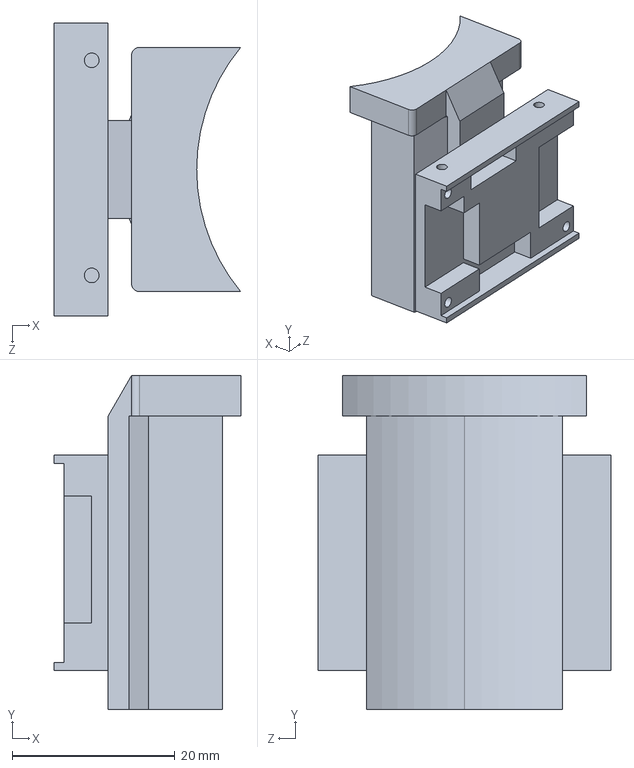
[picture p42: CAD file, 2026-07-08]
3D_Printable_Parts/uc01板块.STEP
22.9 x 41.0 x 36.0 mm
