servodevelop/piper-mate/hardware/step/parts/piper-mate-link1.step

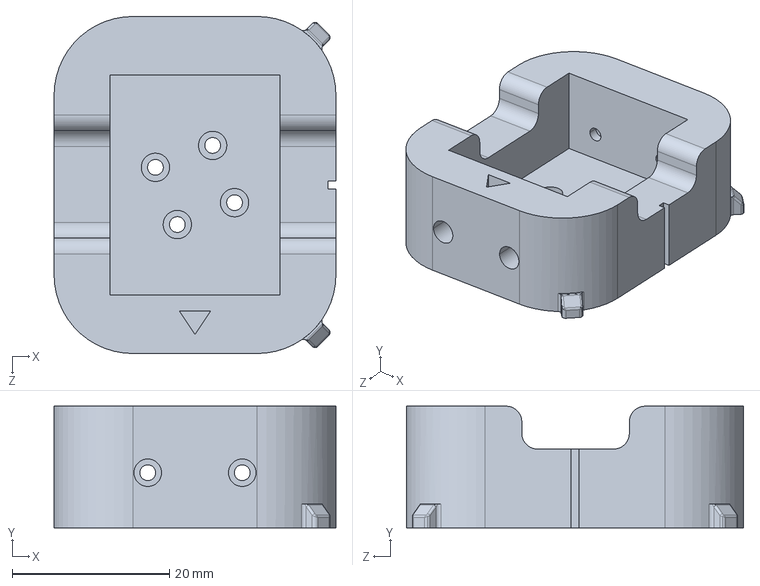
[picture p43: CAD file, 2026-10-30]
hardware/step/parts/piper-mate-link1.step
35.8 x 15.5 x 42.8 mm
