servodevelop/piper-mate/3D_Printable_Parts/link2.STEP

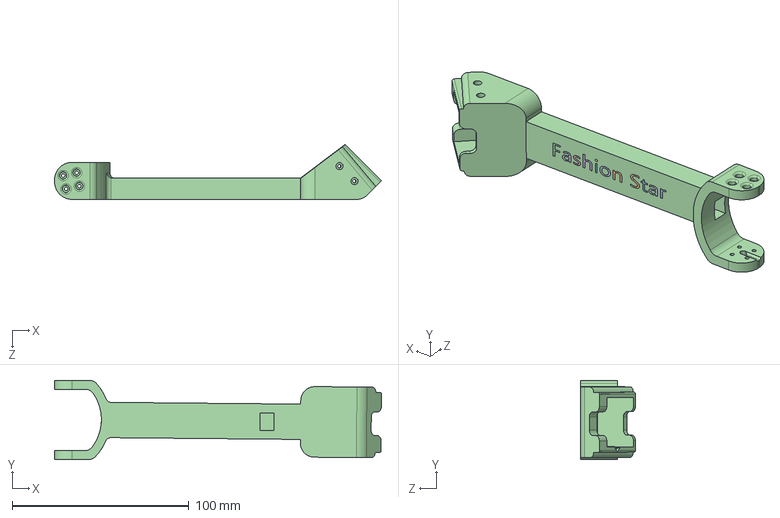
[picture p44: CAD file, 2026-07-08]
3D_Printable_Parts/link2.STEP
185.2 x 44.8 x 31.0 mm
