servodevelop/piper-mate/3D_Printable_Parts/link3.STEP

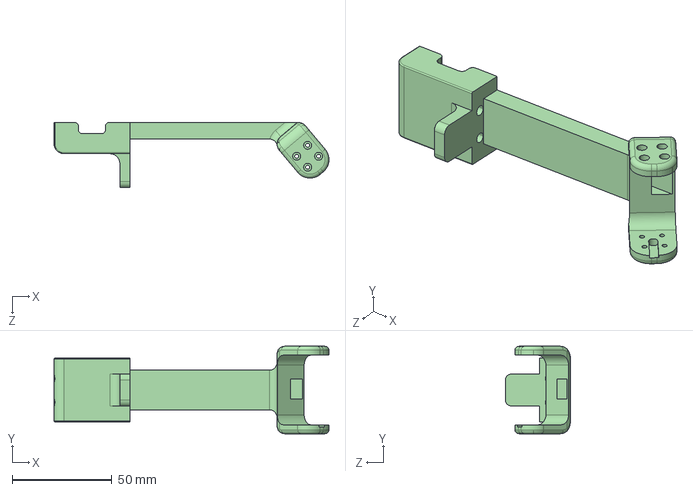
[picture p45: CAD file, 2026-07-08]
3D_Printable_Parts/link3.STEP
137.8 x 43.9 x 32.7 mm
