servodevelop/piper-mate/hardware/step/parts/piper-mate-link3.step

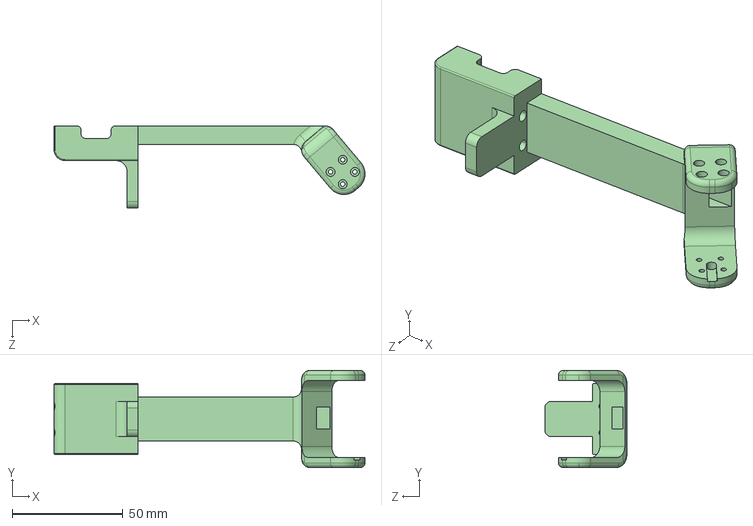
[picture p46: CAD file, 2026-10-30]
hardware/step/parts/piper-mate-link3.step
140.4 x 43.9 x 37.2 mm
