servodevelop/piper-mate/(list of files, cad)

Other CAD files:
hardware/step/assembly/piper-mate.step
hardware/step/parts/piper-mate-base.step
3D_Printable_Parts/手柄.STEP
hardware/step/parts/piper-mate-finger-ring-left.step
hardware/step/parts/piper-mate-c050-handle.step
3D_Printable_Parts/UC01盖子.STEP
3D_Printable_Parts/指环2.STEP
hardware/step/parts/piper-mate-finger-ring-right.step
hardware/step/parts/piper-mate-uc01-mount.step
3D_Printable_Parts/link5.STEP
hardware/step/parts/piper-mate-link4.step
hardware/step/parts/piper-mate-c050-base.step
hardware/step/parts/piper-mate-link2.step
hardware/step/parts/link4.step
hardware/step/parts/uc01-mount.step
hardware/step/parts/link5.step
hardware/printing/3mf/piper-mate-handle.3mf
hardware/printing/3mf/piper-mate.3mf
hardware/stl/piper-mate-c050-base.stl
hardware/stl/piper-mate-c050-handle.stl
hardware/stl/piper-mate-finger-ring-right.stl
hardware/stl/piper-mate-link1.stl
hardware/stl/piper-mate-link2.stl
hardware/stl/piper-mate-link3.stl
hardware/stl/piper-mate-link4.stl
hardware/stl/piper-mate-link5.stl
hardware/stl/piper-mate-uc01-front-case.stl
hardware/stl/piper-mate-uc01-mount.stl
