servodevelop/piper-mate/hardware/assembly-guide/README.md

# Assembly and printing preparation

[← Hardware](../README.md)　|　<sub>**English** / [简体中文](README.zh.md)</sub>

**On this page:**

- [📂 Select matching files](#select)
- [🖨️ Inspect before printing](#print)
- [🔩 Check assembly and wiring](#assemble)
- [🔌 Continue to first connection](#connect)

## 📂 Select matching files

Use the [hardware resource table](../README.md#resources) to choose CAD and print files. Open the complete STEP assembly first, then compare the individual parts and UC-01 enclosure. Both print projects share the same stored profile; neither has a new physical validation report.

## 🖨️ Inspect before printing

The projects target Bambu Lab P1S / PLA / 0.4 mm nozzle. Review plate contents, part quantity, orientation, supports, per-object overrides and build volume in your slicer. The native CAD ZIP preserves filenames; resolve any missing assembly references before exporting new geometry. No fit, strength or load rating is inferred from slicer settings.

## 🔩 Check assembly and wiring

Use the [BOM](../README.md#bill-of-materials) for quantities and connector orientations, and the [dimension drawing](../drawings/piper-mate.pdf) for reference. Confirm servo IDs 0–6 and physical zero positions before fitting links. Keep power off when connecting wiring; verify polarity and cable routing before applying power. A complete numbered assembly guide, fastening torques and wiring pinout have not yet been supplied.

## 🔌 Continue to first connection

After mechanical and electrical checks, follow the [repository quick start](../../README.md). Verify the leader readings before enabling follower motion.
