servodevelop/piper-mate/hardware/drawings/piper-mate.pdf

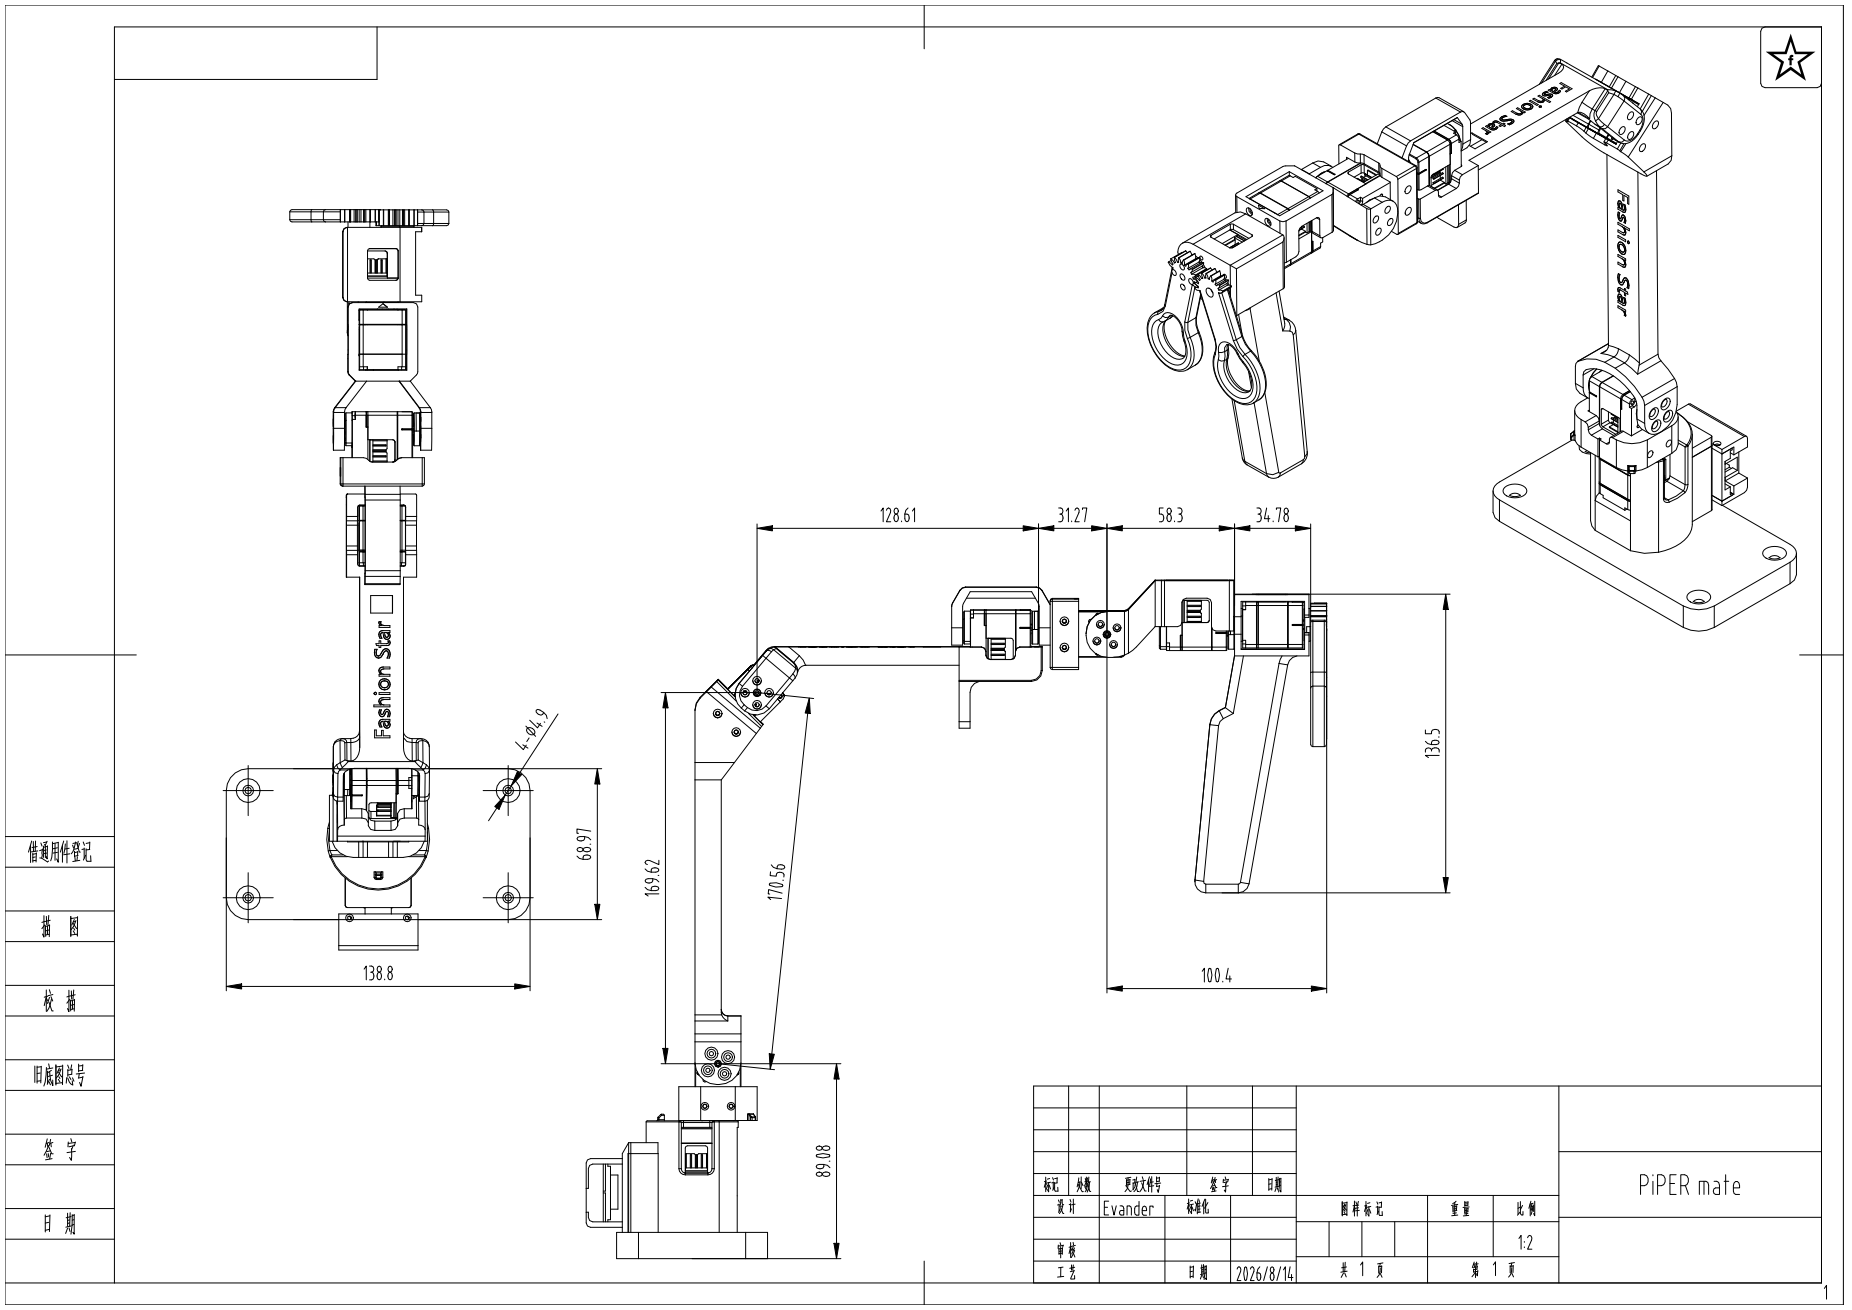
[picture p47: page 1]
