servodevelop/piper-mate/(commit log)

2025-12-19 update control frequency and reset multi-turn angle
    [fashionstar_agilex.py, star_piper.py]
2025-12-22 Rename motors_type to motors_pos_type and update joint names with .pos suffix
2026-09-06 docs: connect PiPER-Mate to the Star Arm 102 ecosystem
    Translate the existing README into English and preserve the Chinese documentation in README.zh.md. Add role-specific Ecosystem links to the central Star-Arm-102 repository and official series landing page. Preserve technical instructions, specifications, and business information.
    Validation: checked English default README, direct Chinese language link, exact destination URLs, and absence of links to other spoke repositories. Only README documentation is changed.
2026-10-27 feat(hardware): 建立与 102 同构的硬件资料目录
    - 新建 hardware/：README.md/README.zh.md、step/{assembly,parts}、stl/{,downloads}、drawings、images、assembly-guide、cad-source、printing/3mf
    - 12 份零件 STEP 由原 3D_Printable_Parts 整理并改用英文名；补 piper-mate.step 整机装配、SolidWorks 源包、PDF/DWG 图纸
    - 由 STEP 重新生成 12 份闭合二进制 STL 与下载包（包内逐字节一致）
    - 补 12 张零件白底渲染图、5 张产品图和尺寸图；BOM 按 102 的六列表格整理为 19 项
    - 删除重复的 3D_Printable_Parts/ 与 3D_Printed_Parts，根 README 增加硬件入口
2026-10-27 docs(hardware): 标注装配体与零件版本对应关系待验证
2026-10-27 feat(hardware): 按 2026-10-27 发布资料补齐 BOM 与打印工程
    - 核对装配体与 11 份零件 STEP 为发布文件夹最新版本，逐字节一致，未改动几何
    - 新增手柄多件 3MF，移除被 9.1 工程取代的旧 30% 填充工程
    - 新增 BOM 源表，补充 10 个随箱配件/包装条目（装机 19 项 + 配件 10 项）
    - 同步中英 README 与装配指南的打印说明
2026-10-27 refactor(hardware): 按 102 精简目录，移除 3MF 与附属源文件
    - 删除 hardware/printing、cad-source、assembly-guide、bom，保留 102 同构的 README、step、stl、drawings、images
    - 中英 README 去掉 3MF/打印工程、SolidWorks 源包和 BOM 源表引用；STL 作为唯一打印入口
    - 确认装配体与 11 份零件 STEP 为发布文件夹最新版；uc01-cover 无新 STEP，沿用上一版
2026-10-27 fix(hardware): 删除重复的 UC-01 盖子版本，BOM 合并为单表
    - 保留最新的 uc01-front-case，删除 uc01-cover 的 STEP、STL 与渲染图
    - STL 下载包重建为 11 个条目，与散件逐字节一致
    - BOM 合并为一张连续 29 行表：1–19 装机物料，20–29 随箱配件
    - 中英 README 同步更新 11 个零件、BOM 与说明
2026-10-29 feat(hardware): 补充 BOM 舵机与标准件图片
    - 新增 RP6-U15H-M 舵机图，BOM 第 1 行使用
    - 从 102 复用同头型紧固件示意图：M2×8 内六角、M2×4.5 十字盘头、M3 螺母，并补 UC-01 图
    - 图片仅作示意，规格以文字列为准；M3×10 沉头螺钉暂无匹配图，仍为待补
2026-10-30 feat(hardware): 按 102 规范重命名装配树与零件标识
    - 装配树改为 piper-mate-base、piper-mate-link 1–5、piper-mate-handle、piper-mate-finger-ring-right/left
    - 零件文件改为 piper-mate-c050-base、piper-mate-c050-handle、piper-mate-link1–5、左右指环，UC-01 前壳/安装板同步加前缀
    - BOM 的 Part Name / Model、STEP、STL 与下载包同步；几何未改
2026-10-30 feat(hardware): 更新 UC-01 part
    - 将 UC-01 前壳与安装板加入 BOM（第 11–12 项）
2026-10-30 feat(hardware): 按 102 结构整理装配设计树
    - 增加 3D Printed Parts (11) 与 Servos (7) 分组
    - 舵机改为 J1-ID0-RP6-U15H-M 至 J7-ID6-RP6-U15H-M (Handle)
    - 几何保持 105 solids / 432.2031 cm³
2026-10-30 feat(hardware): 新增 C050 装配体并按 102 结构整理
    - 新增 step/assembly/piper-mate-c050.step
    - 分组为 3D Printed Parts (11)、Servos (7)、Servo Horns (11)
    - 打印件统一使用 piper-mate-c050- 前缀，舵机实例名为 J1–J7
2026-10-30 revert(hardware): 移除 C050 装配体入库
    - C050 改为单独交付 STP，不进入仓库
2026-10-30 fix(hardware): 舵机实例名按 J1-ID0–J7-ID6 标注
    - 标准装配树保持 J1-ID0-RP6-U15H-M … J7-ID6-RP6-U15H-M (Handle)
    - BOM 第 1 行描述同步为 J1-ID0–J7-ID6
2026-10-30 fix(hardware): 舵机实例名与 J1-ID0–J7-ID6 对齐
    - 标准装配体的七个舵机加入 J1-ID0–J7-ID6 实例名
    - 每个舵机保留独立 PRODUCT 名称
2026-10-31 docs(hardware): 完善双语 BOM 品名与连接线、螺丝配图
    统一基座、连杆、手柄、指环及转接板外壳的中英文品名；补充四种连接线图片和线长标注，修正 A2007 / PH2.0 接头展示。
    补充 M3 × 10 沉头螺钉图片与 PM 前缀，替换两颗 M1.6 × 4 螺钉图片并缩小其画面占比；标明 AI 示意图用途。
    验证：硬件文档本地链接与双语结构检查通过，git diff --check 通过，内置浏览器预览确认图片加载。当前分支未提供检查脚本，复用 Star-Arm-102 检查器并限定硬件文档对。
2026-11-01 docs(hardware): 精简 BOM 并统一 STEP 与 3MF 资源结构
    - BOM 保留 1–21 项装机物料，移除随箱配件、包装及相关说明
    - 移除 BOM 下方的 CAD 展示和 UC-01 零件文件说明
    - 整机装配 STEP 直接放在 hardware/step/，删除单件 STEP 目录
    - 删除独立 STL 和下载包，按 Star-Arm-102 结构预留 3mf/，标注待提供
    - 同步中英文首页和硬件文档，移除失效零件下载链接，保留零件标识
    验证：中英文硬件文档结构检查通过；本次未新增本地链接错误；装配体移动前后 Git blob 一致；git diff --cached --check 通过。
    已有问题：根目录两份 README 的 LICENSE 链接目标仍缺失，H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
2026-11-01 docs(hardware): 独立关节 ID 文档并校准 BOM 标识
    - 硬件页按产品图、资源目录、BOM 排列，产品规格集中到中英文首页
    - 合并已有硬件规格，修正首页关节 3 行程为 −102° 至 +102°
    - 新增 docs/specifications.md 与 specifications.zh.md，独立维护七个通道的关节、舵机 ID 和软件名称对照，以及从臂指令限位
    - 核对 Python SDK、LeRobot 与 ROS 2 的实际命名，首页和硬件页添加对应语言入口
    - BOM 的 11 个打印件标识与 STEP 装配树逐字一致，保留连杆编号前空格，移除旧 Piper mate_ID 编号
    验证：硬件和新增对照文档的双语结构检查通过；本次未新增本地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
2026-11-01 docs(hardware): 统一 BOM 标识并更新打印件实物配色图
    统一中英文 BOM 的型号 / 规格表头，将打印件标识改为不带文字修饰的稳定名称，连杆使用 piper-mate-link1 至 link5；移除 BOM 标识与 STEP 显示名称完全一致的说明。
    以当前 FreeCAD 基座视角为基准，重新导出 11 个打印件的白底 PNG，统一 1200 × 1200、居中与留白。连杆 2、连杆 3、手柄及 UC-01 转接板底座采用黄色，其余采用米白色；保留连杆白色字体及原始孔位、开槽和几何。
    验证：硬件中英文文档链接与结构检查通过；11 张图片尺寸、白底、居中和完整边界检查通过；STEP 校验值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
