servodevelop/piper-mate/(notices)

Notices in the files:
README.md:
License: MIT
